lochidev/ttsky25_two_stage_opamp/docs/Report On Design Task.pdf

# Report on Design Task: A Low-power Single-ended Operational Amplifier using Sky130 PDK

1

st Lochana Katugaha
Undergraduate, Department of Electrical and Electronic Engineering Sri Lanka Institute of Information Technology Malabe, Sri Lanka
lochanakatugaha.a30@gmail.com

Abstract—This report documents a single-ended op-amp circuit design using the SKY130 PDK, intended to function as a non-inverting unity-gain buffer for low-frequency analog signals (1–10 kHz) that will be submitted to the Analog IC Student Design Contest organized by IEEE CASS CEDA Joint SL Chapter and SkillSurf.

I. INTRODUCTION

The aim of this report is to document the submitted design so that anyone can understand the design decisions that were made to build a two-stage op-amp with miller compensation using the open source, Sky130A PDK. Fig. 1 shows the circuit that was designed to meet the required specifications.

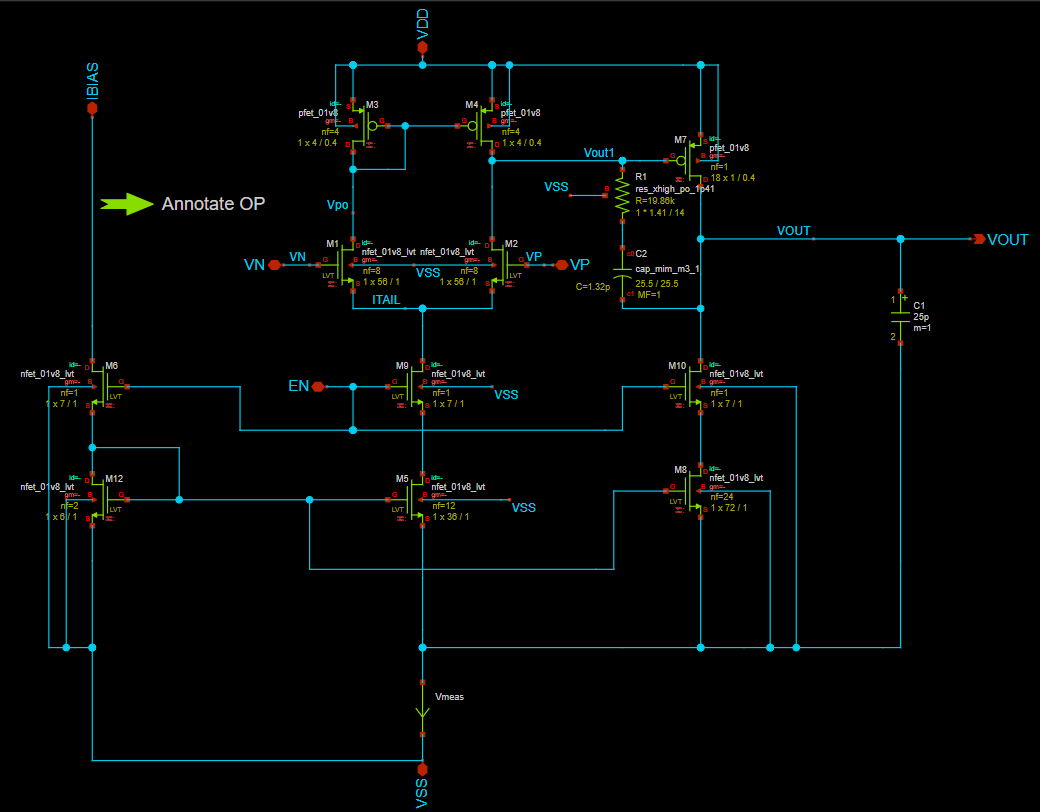
[picture p3: figure]

Fig. 1. The circuit that was designed.

II. DESIGN INPUTS AND TARGET SPECIFICATIONS

The amplifier must operate within strict power and performance constraints, targeting low-voltage and low-area applications. A non-inverting unity-gain buffer should present a high input impedance to avoid loading the preceding stage, while maintaining a low output impedance. According to [1], a higher open-loop gain results in a lower output impedance when the op-amp is used as a unity-gain buffer.

TABLE I
DESIRED PROJECT PERFORMANCE SPECIFICATIONS
Parameter | Project Specification
Technology Supply voltage VDD Nominal input common-mode voltage Output load CL Temperature range Input signal amplitude Input signal frequency Open-loop low-frequency (DC) gain ADC Gain bandwidth product (GBW) Phase Margin (PM) Quiescent current Input offset Slew rate (both open-loop and closed-loop) SR Disable current Final layout area | 130 nm CMOS 1.7 V – 1.9 V (VDD/2 − 0.2 V) – (VDD/2 + 0.2 V) 25 pF (capacitive) 20◦C to 50◦C < 0.4 Vpp 1 – 10 kHz ≥ 60 dB ≥ 1 MHz > 60◦ < 100 µA < 3 mV > 1 V/µs < 2 nA within 140 µm × 80 µm

III. POST-LAYOUT SIMULATION RESULTS
In this section, screenshots of the post layout results after parasitic extraction through magic have been included followed by Table III with a summary. All results have been obtained keeping VDD constant at 1.8 V and nominal input common-mode voltage at 0.9 V (VCM) while also using the lib file:
.lib /foss/pdks/sky130A/libs.tech/ngspice/sky130.lib.spice tt.

It was found that the circuit performs poorly (only in terms of open-loop DC gain) in the sf corner with increasing common mode voltages and Table II records the performance. Figures Fig. 2 and Fig. 3 show the open-loop low-frequency (DC) gain post-layout simulation results for the tt corner at temperatures 20◦C and 50◦C respectively.
Fig. 4 shows the normal operating point simulation result and Fig. 5 shows the operating point simulation result with enable set to logic LOW.
Fig. 6 shows the voltage transfer curve for the op-amp. Fig. 7 and Fig. 8 show open-loop transient simulation results at 1 kHz and 10 kHz respectively for a 0.1 mV sinusoidal input signal. Fig. 9 shows closed-loop transient simulation results at 1 Mhz for a sinusoidal signal of 0.4 Vpp magnitude with VCM = 0.9 V .
Fig. 10 shows transient behavior of the design in a open-loop slew rate test when a -0.4V pulse signal is applied. Fig. 11 shows a graph that shows the corresponding instantaneous slew rate.

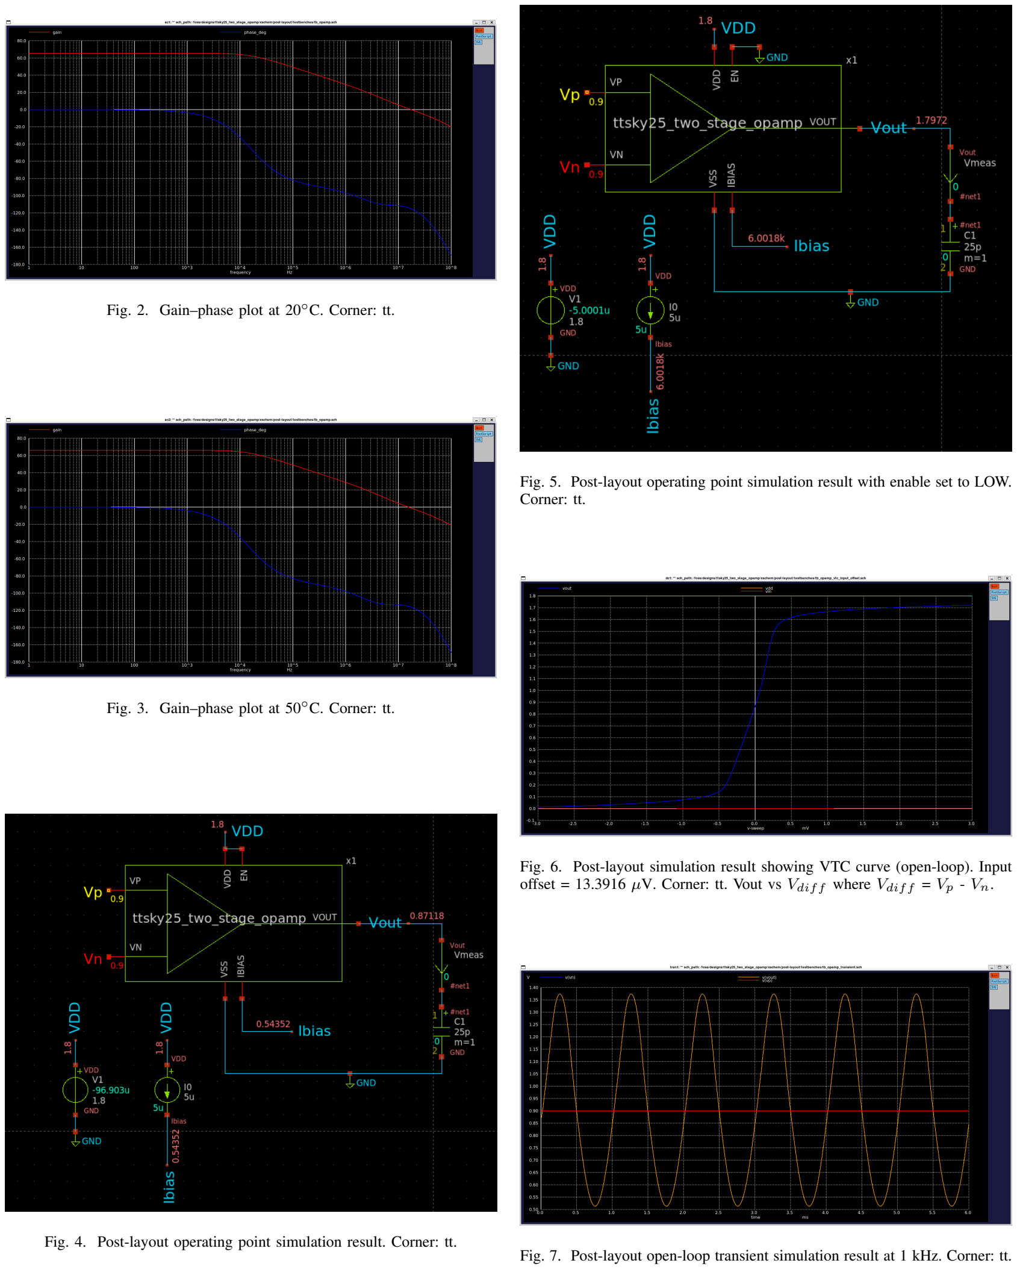
[picture p4: page 2]

Fig. 2. Gain–phase plot at 20◦C. Corner: tt.

Fig. 3. Gain–phase plot at 50◦C. Corner: tt.

Fig. 4. Post-layout operating point simulation result. Corner: tt.

Fig. 5. Post-layout operating point simulation result with enable set to LOW. Corner: tt.

Fig. 6. Post-layout simulation result showing VTC curve (open-loop). Input offset = 13.3916 µV. Corner: tt. Vout vs Vdiff where Vdiff = Vp - Vn.

Fig. 7. Post-layout open-loop transient simulation result at 1 kHz. Corner: tt.

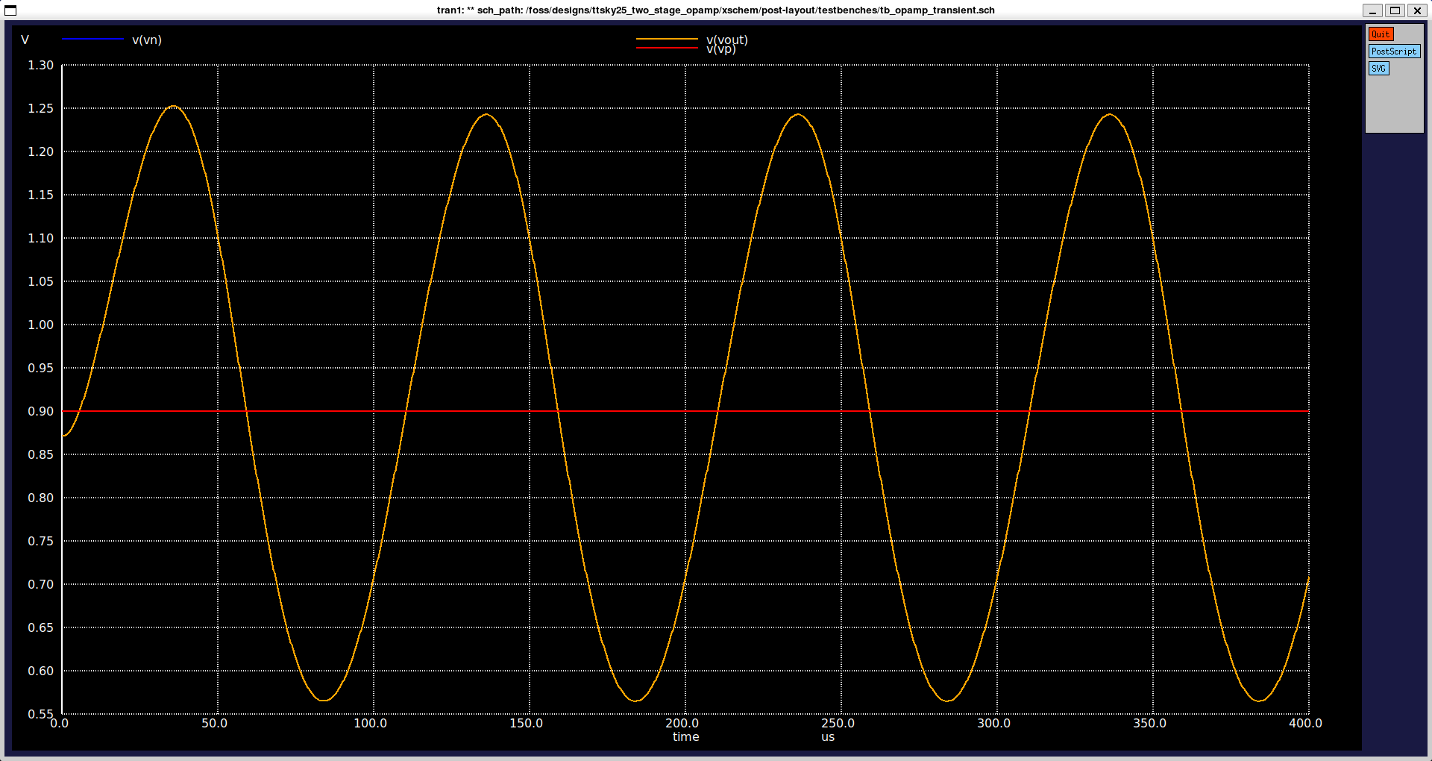
[picture p5: figure]

Fig. 8. Post-layout open-loop transient simulation result at 10 kHz. Corner: tt.

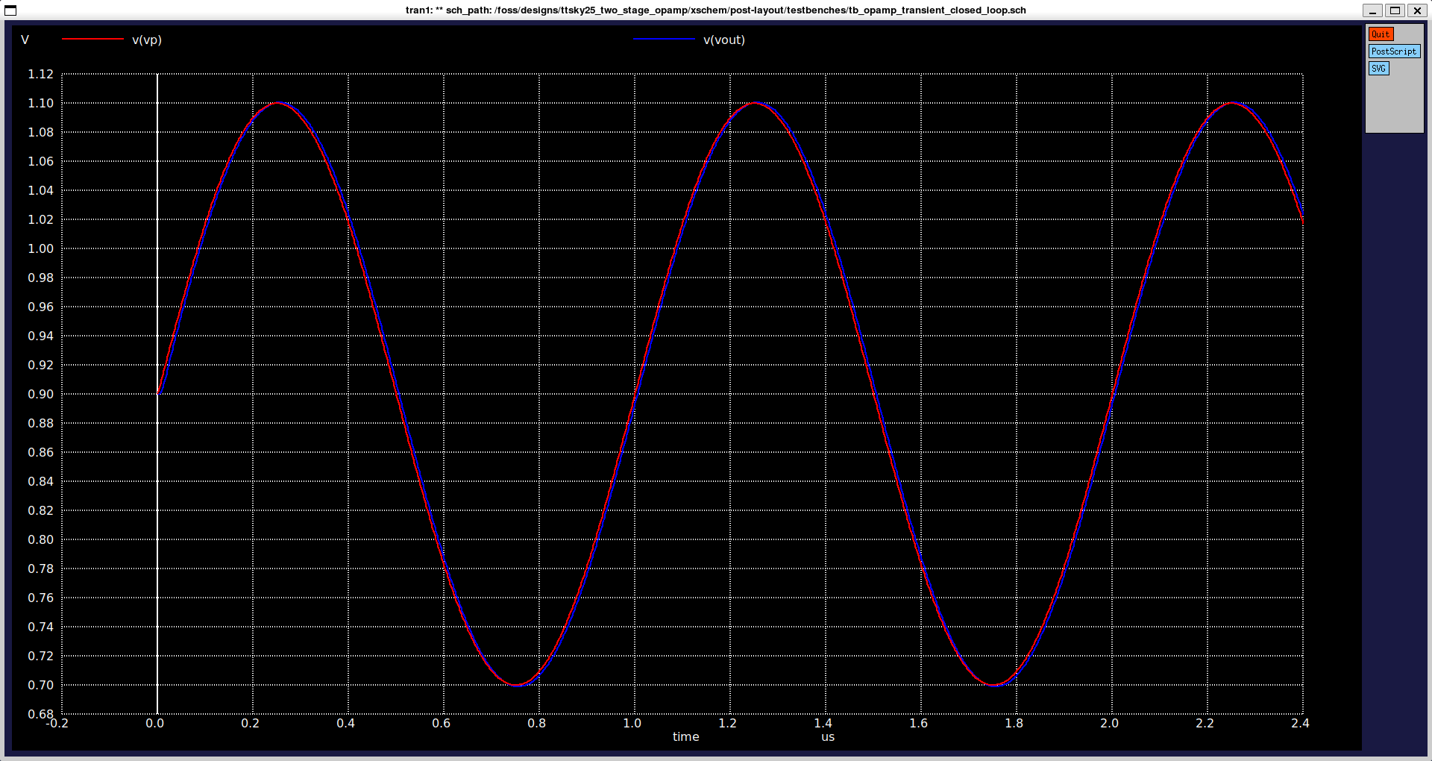
[picture p6: figure]

Fig. 9. Post-layout closed-loop transient simulation result at 1 MHz. Corner: tt.

Fig. 12 shows transient behavior of the design in a closed-loop slew rate test when a -0.4V pulse signal is applied. Fig. 13 shows a graph that shows the corresponding instantaneous slew rate.

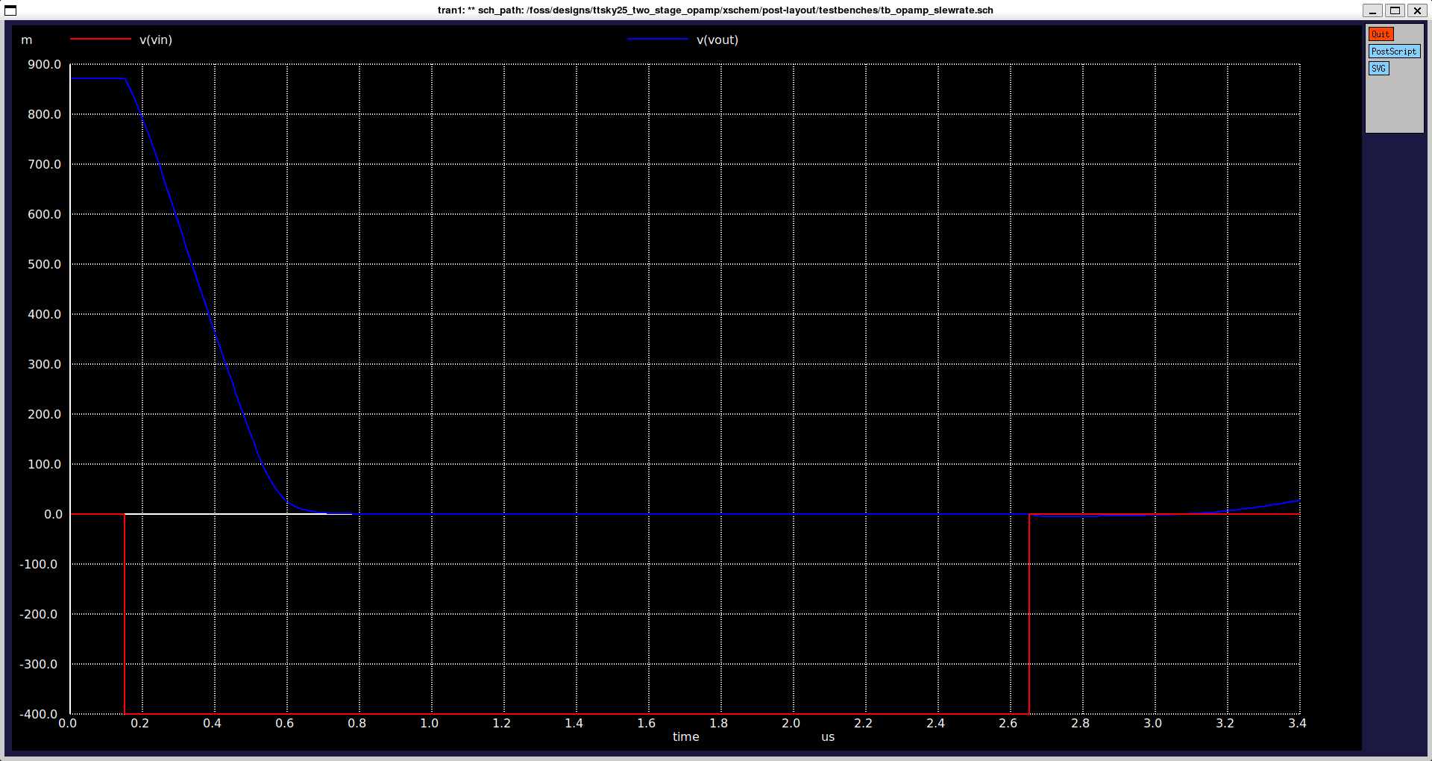
[picture p7: figure]

Fig. 10. Post-layout simulation result for open-loop slew rate transient behavior. Corner: tt.

Fig. 14 shows a cropped version of the plot of gain (dB) vs temperature (◦C) found at [4].
The testbenches used to obtain these results are modified versions of the testbenches found at [2].

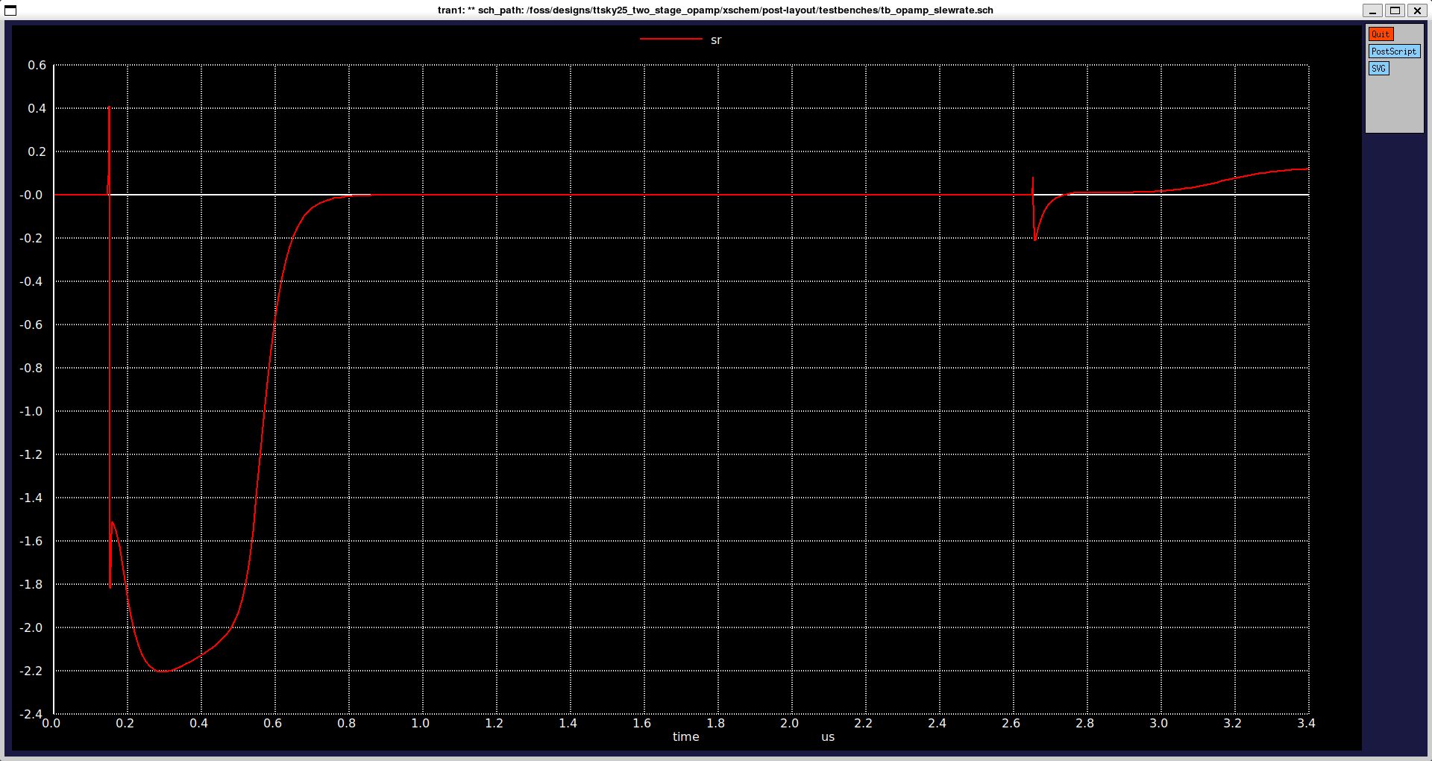
[picture p8: figure]

Fig. 11. Post-layout simulation result showing instantaneous slew rate (derivative) for plot in Fig. 10. Corner: tt.

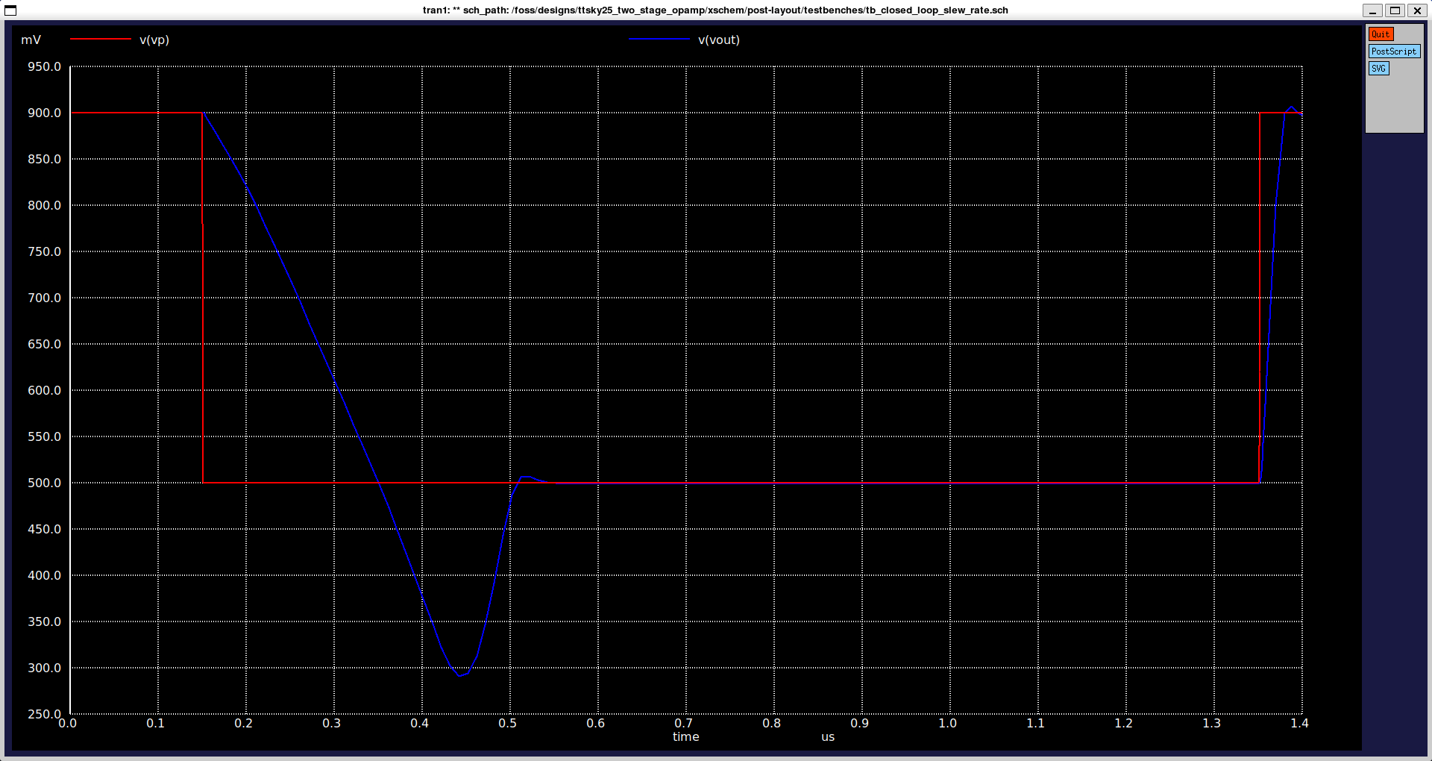
[picture p9: figure]

Fig. 12. Post-layout simulation result for closed-loop slew rate transient behavior. Corner: tt.

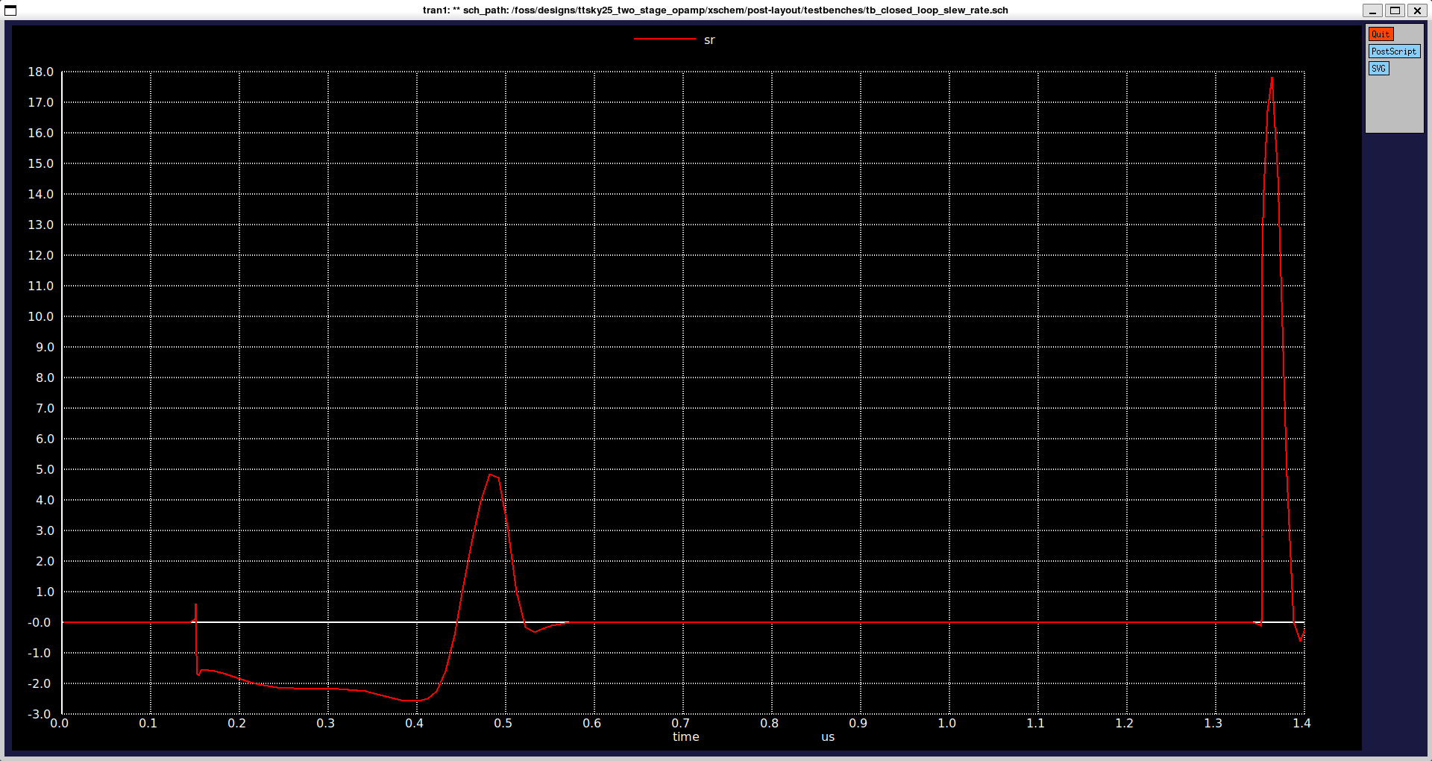
[picture p10: figure]

Fig. 13. Post-layout simulation result showing instantaneous slew rate (derivative) for plot in Fig. 12. Corner: tt.

TABLE II
EFFECT OF VCM ON OPEN-LOOP DC GAIN IN THE SF CORNER
VDD | VCM | Required ICMR | Temperature | Open-loop DC gain
1.8 V | 1.1 V | 0.7 V - 1.1 V | 20◦C | 43.050 dB
1.8 V | 1.01 V | 0.7 V - 1.1 V | 20◦C | 60.125 dB
1.7 V | 1.01 V | 0.65 V - 1.05 V | 20◦C | 37.141 dB
1.7 V | 0.89 V | 0.65 V - 1.05 V | 20◦C | 60.628 dB
1.9 V | 1.01 V | 0.75 V - 1.15 V | 20◦C | 64.127 dB

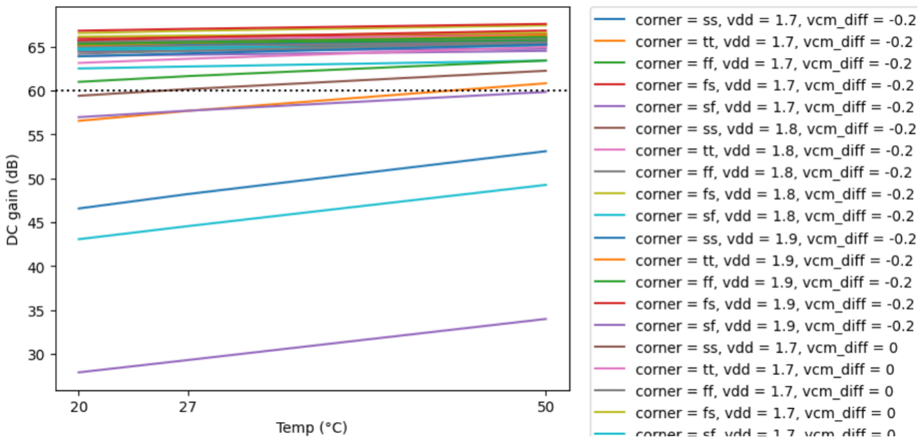
[picture p11: figure]

Fig. 14. A plot of gain (dB) vs temperature (◦C) for varying VDD, common-mode input voltage and process corners obtained through post-layout simulations using CACE. (Source: See [4])

| TABLE III
SUMMARY OF SPECIFICATIONS ACHIEVED ACROSS PVT VARIATIONS
| (VDD = 1.8 AND VCM = 0.9)
Required Specification | Post-layout results
Process corner | Temp | Value
Input Common-Mode Voltage Range | tt | 27◦C | Min: 0.6 V Max: 1.1 V
Input Common-Mode Voltage Range (Worst case) | sf | 20◦C | Min: 0.6 V Max: 1.01 V
Open-loop low-frequency (DC) gain (Max value observed) | tt ff ss sf fs tt ff ss sf fs | 20◦C 20◦C 20◦C 20◦C 20◦C 50◦C 50◦C 50◦C 50◦C 50◦C | 65.522 dB 65.346 dB 65.195 dB 63.934 dB 66.004 dB 66.059 dB 65.772 dB 65.755 dB 64.512 dB 66.494 dB
Gain bandwidth product (Assuming GBW = UGF) | tt ff ss sf fs tt ff ss sf fs | 20◦C 20◦C 20◦C 20◦C 20◦C 50◦C 50◦C 50◦C 50◦C 50◦C | 17.67 MHz 19.18 MHz 15.93 MHz 16.52 MHz 18.20 MHz 15.72 MHz 17.00 MHz 14.22 MHz 14.76 MHz 16.14 MHz
Phase margin | tt | 20◦C | 64.684◦
| ff | 20◦C | 65.191◦
| ss | 20◦C | 63.994◦
| sf | 20◦C | 64.573◦
| fs | 20◦C | 64.605◦
| tt | 50◦C | 64.754◦
| ff | 50◦C | 65.580◦
| ss | 50◦C | 63.663◦
| sf | 50◦C | 64.323◦
| fs | 50◦C | 64.896◦
Quiescent current | tt | 27◦C | 96.903 µA
Input offset | tt | 27◦C | 13.3916 µV
Slew rate (open-loop, negative pulse) | tt | 27◦C | -2.20 V/µs
Slew rate (open-loop, positive pulse) | tt | 27◦C | 15.88 V/µs
Slew rate (closed-loop, negative pulse) | tt | 27◦C | -2.56 V/µs
Slew rate (closed-loop, positive pulse) | tt | 27◦C | 8.10 V/µs
Disable current | tt | 27◦C | 100 pA
Output node current | tt | 27◦C | -
Layout area | - | - | 48.5 ∗ 57.26 µm²

IV. MONTE CARLO SIMULATION RESULTS
Fig. 15 shows a histogram made using data obtained through 4500 tests run by CACE. The default documentation generated by CACE (including Monte Carlo results) can be found at [4]. The MC switch found in the combined sky130.lib.spice file was used for this, and the full data set can be found at [6]. These Monte Carlo results were obtained using, 150 MC switch process variations each for 3 temperature variations (20◦C, 27◦C, 50◦C) * 3 VDD variations (1.7 V, 1.8 V, 1.9 V) * 3 VCM variations. The VCM variations were calculated depending on the VDD value, as shown in (1) where VCM diff was constrained to three discrete values (0, +0.2 V, and −0.2 V).
V DD
2

− VCM diff
≤ VCM ≤
V DD
2

+ VCM diff
(1)

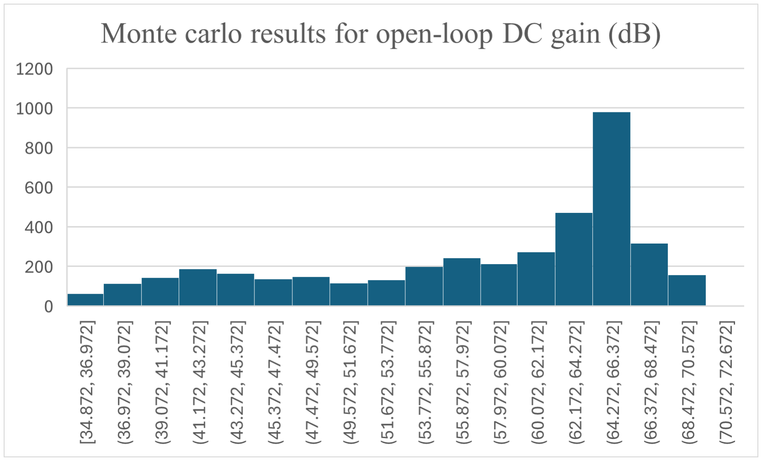
[picture p12: figure]

Fig. 15. Monte Carlo simulation attempt with 4050 runs

TABLE IV
AN ATTEMPT AT 3-SIGMA ANALYSIS OF DC GAIN USING 4500 MONTE CARLO RUNS
Mean open-loop DC gain | 57.72378807 dB
Standard Deviation | 9.412357149 dB
Median | 61.70855 dB
1σ - Count and percentage | 2850 (70.370%)
2σ - Count and percentage | 3883 (95.877%)
3σ - Count and percentage | 4050 (100%)
V. SIZING TRANSISTORS
A. Sky130A PDK Specific Considerations
Different results were obtained depending on the different sky130.lib.spice file that was used. They are found in the lib.tech folder:
.lib/foss/pdks/sky130A/libs.tech/ngspice/sky130.lib.spice, .lib/foss/pdks/sky130A/libs.tech/combined/sky130.lib.spice.

In order to match the results obtained by these different files it was decided that the design would use only ”binned” W
L
ratios found in files such as:

”/foss/pdks/sky130A/libs.ref/sky130 fd pr/spice/sky130 fd pr nfet 01v8 lvt tt discrete.corner.spice” and ”/foss/pdks/sky130A/libs.ref/sky130 fd pr/spice/sky130 fd pr pfet 01v8 tt discrete.corner.spice”.

Due to various community discussions such as [3] and
[5] about the the pfet 01v8 model, it was decided that the maximum channel length of PFETs used in the design would be 0.4 µm.

VI. LAYOUT
A. Completed layout and layout plan
It was ensured that the layout was compact, had 0 DRC errors and was passing LVS. Area used by the layout is 2777.110 µm² with a width of 48.500 µm and a length of 57.260 µm. Fig. 16 shows the completed layout. Fig. 17 shows the layout plan.

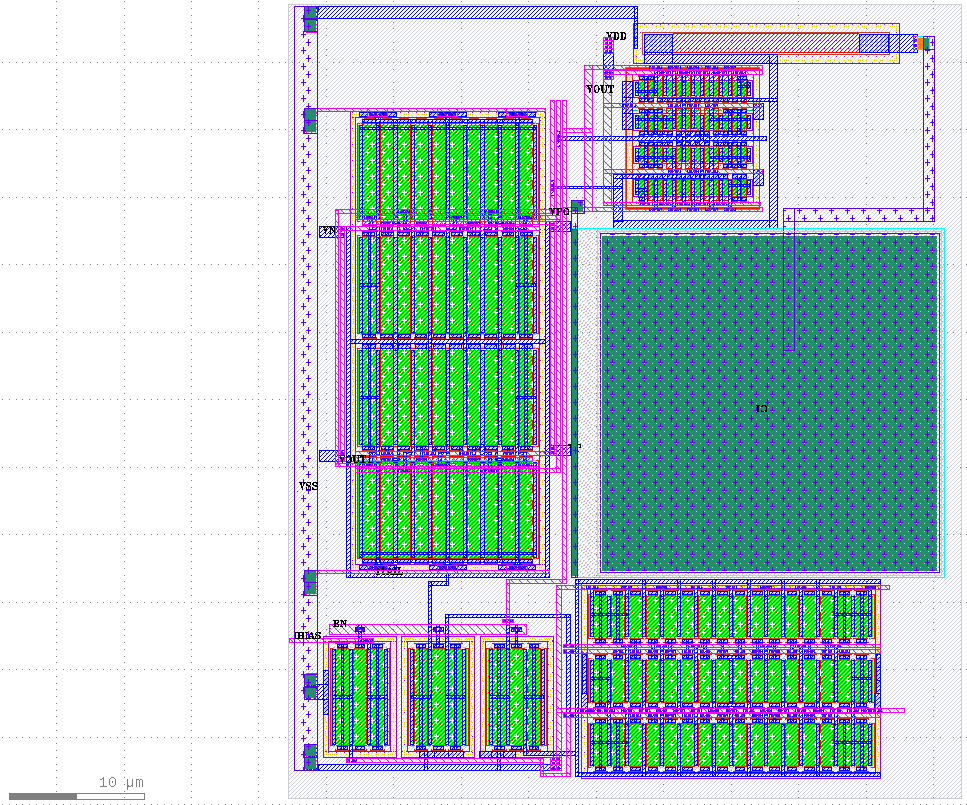
[picture p13: figure]

Fig. 16. Final layout of the two stage operational amplifier.

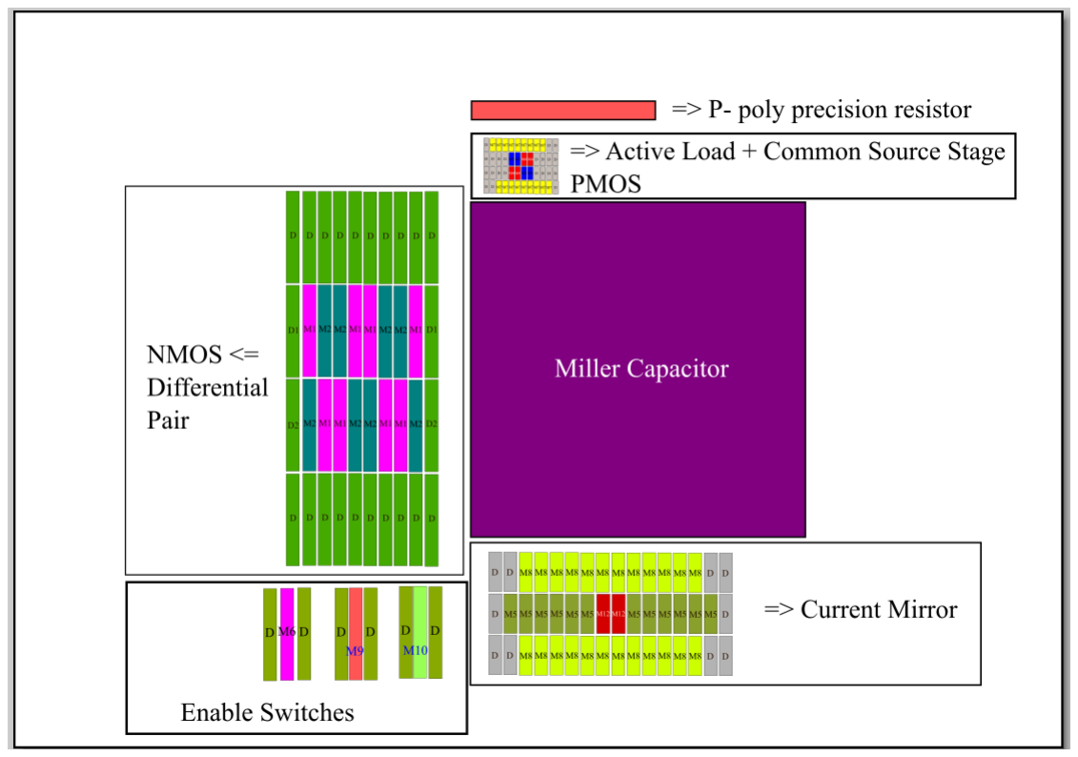
[picture p14: figure]

Fig. 17. Layout plan for the two stage operational amplifier.

B. Explanation of the layout of the NMOS differential pair

This was the most crucial part of the layout as the two MOSFETs M1 and M2 needed to be matched with very high accuracy. A common centroid layout made of 8 fingers each from M1 and M2 was used with each finger having a

W
L

=

7/1. These are the largest fingers in terms of size in the entire layout, which may make it more susceptible to process gradients. Therefore, these fingers were placed as close as possible. Attempts were made to ensure that routing was symmetrical as well. The differential pair was surrounded by dummy transistors. There may be unforeseen complications arising due to the D1 and D2 dummy transistors being connected to the drains of M1 and M2, respectively. This was only noted after completing much of the layout and when changes were made to it so that all the terminals were connected to the source node (ITAIL) of M1 and M2, the post-layout results were worse, so the decision was made to keep it as it is. Fig. 18 shows the layout plan of the NMOS differential pair.

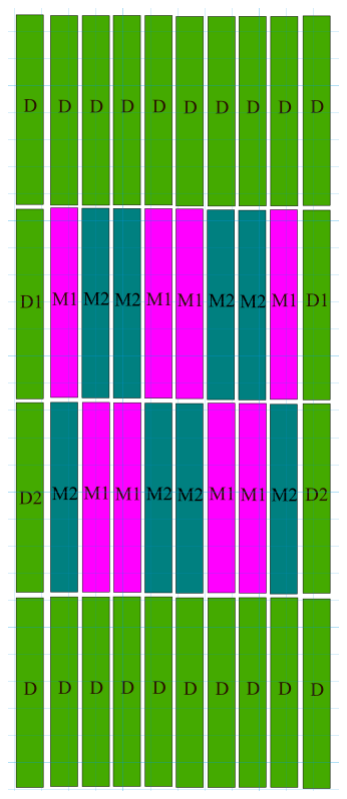
[picture p15: figure]

Fig. 18. Layout plan for the NMOS differential pair.

C. Explanation of the layout of the PMOS active loads and the common source stage input MOSFET

This was the second most crucial part of the layout as the two MOSFETs that form the active loads of the first stage, M3 and M4 needed to be matched. The common source stage MOSFET M7 also needed to be matched. A common centroid layout made of 4 fingers each from M3 and M4 was used with each finger having a W
L

=

1
0.4

. M3 and M4 are surrounded by dummy transistors from all sides, while M7 was only surrounded by the left and right to save time during layout so that post-layout simulations could be performed as soon as possible. Fig. 19 shows the layout plan of these PFETs.

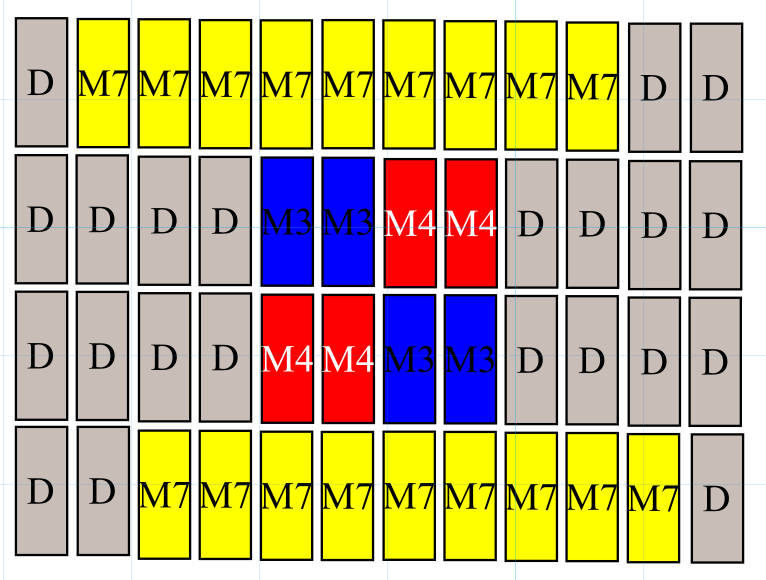
[picture p16: figure]

Fig. 19. Layout plan for all the PFETs in the layout.

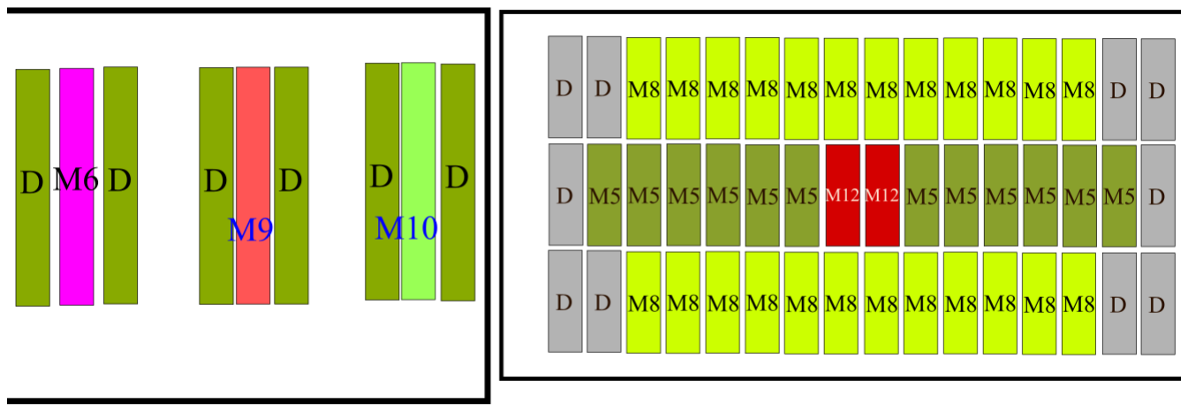
[picture p17: figure]

Fig. 20. Layout plan for current mirror and enable switches.

D. Explanation of the layout of the NMOS current mirror and enable switches
This was also a crucial part of the layout as the three MOSFETs M12, M5 and M8 needed to be matched. The enable switches were not matched to save time and were laid out seperately from the current mirror. An attempt at a common centroid layout made of 38 fingers with each finger having a W
L

=

3
1 was made. The goal here was to keep M5 and M8 as close as possible to M12 since M12 was considered as the reference device. M5 is surrounded by identical fingers (including dummy transistors) on all sides however M8 is only surrounded by the left and right sides. Fig. 20 shows the layout plan for the current mirror and enable switches. The enable switches also had dummy transistors on the left and right but they may not be required.

VII. CONCLUSION
Since the post-layout results obtained in the sf corner showed poor performance, the design may not be able to operate with common mode voltage inputs above 1.01 V. Power supply variations may affect performance even further. In conclusion, it can be said that the design, even for most PVT variations, can act reliably as a non-inverting unity-gain buffer for low-frequency analog signals with a magnitude of about 0.4 Vpp if used with a DC offset of about 0.8 V while keeping VDD constant at 1.8 V. Fig. 21 shows post-layout results under such conditions.

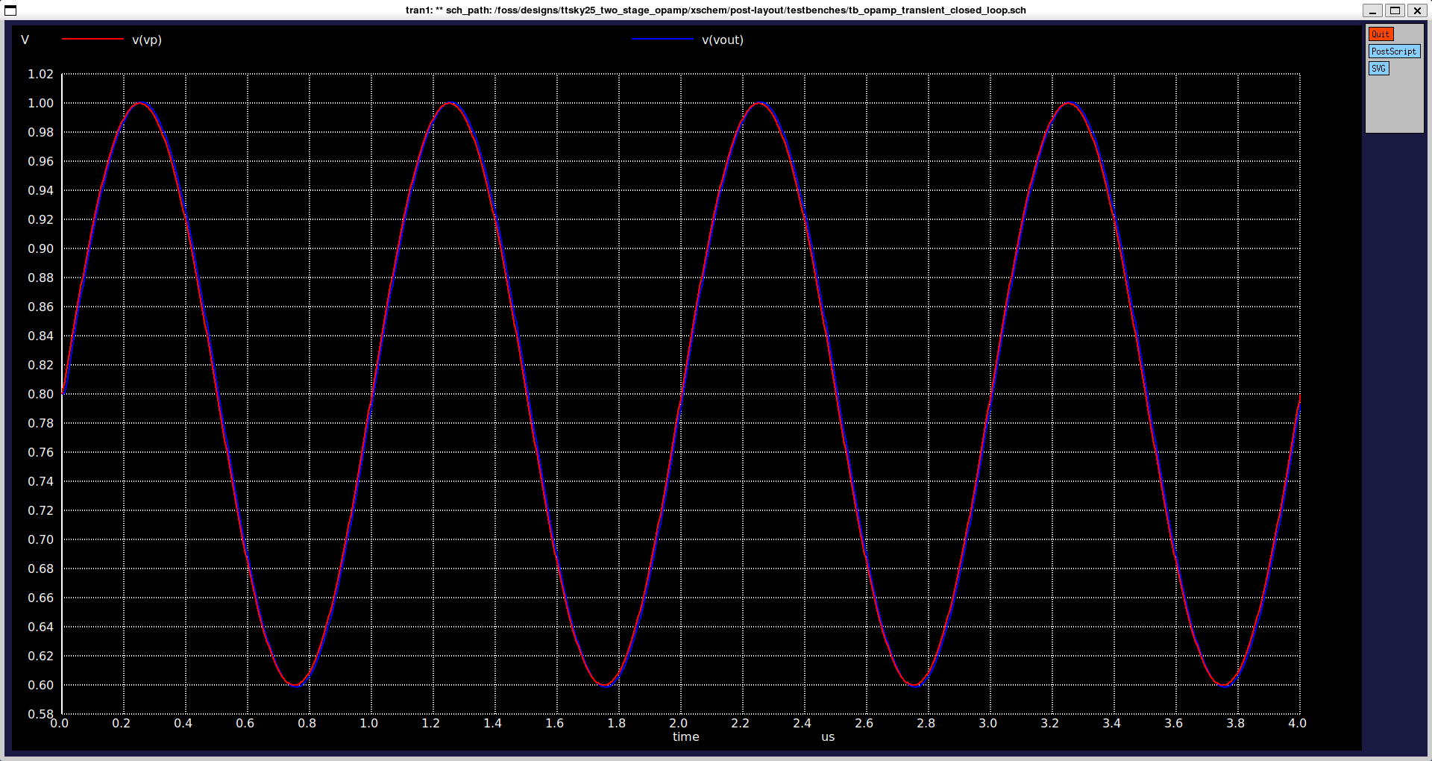
[picture p18: figure]

Fig. 21. Post-layout closed-loop transient simulation result at 1 MHz for 0.4 Vpp signal. Corner: sf.

REFERENCES

[1] B. Razavi, Design of Analog CMOS Integrated Circuits, 2nd ed. New York, NY, USA: McGraw-Hill, 2016, p. 288.
[2] https://github.com/SkillSurf/ttsky25 se opamp/tree/main/xschem (https://github.com/SkillSurf/ttsky25_se_opamp/tree/main/xschem)
[3] https://github.com/bmurmann/Book-on-gm-ID-design/blob/main/ starter files open source tools/sky130/README.md (https://github.com/bmurmann/Book-on-gm-ID-design/blob/main/starter_files_open_source_tools/sky130/README.md)
[4] https://github.com/lochidev/ttsky25 two stage opamp/blob/main/docs/ ttsky25 two stage opamp rcx.md (https://github.com/lochidev/ttsky25_two_stage_opamp/blob/main/docs/ttsky25_two_stage_opamp_rcx.md)
[5] https://web.open-source-silicon.dev/t/16600198/are-there-near-plansto-fix-the-skywater-analog-models-the-m (https://web.open-source-silicon.dev/t/16600198/are-there-near-plans-to-fix-the-skywater-analog-models-the-m)
[6] https://github.com/lochidev/ttsky25 two stage opamp/blob/main/docs/ results/monte-carlo/mc 4050.xlsx (https://github.com/lochidev/ttsky25_two_stage_opamp/blob/main/docs/results/monte-carlo/mc_4050.xlsx)
