lochidev/ttsky25_two_stage_opamp/docs/ttsky25_two_stage_opamp/rcx/gain_mm.png

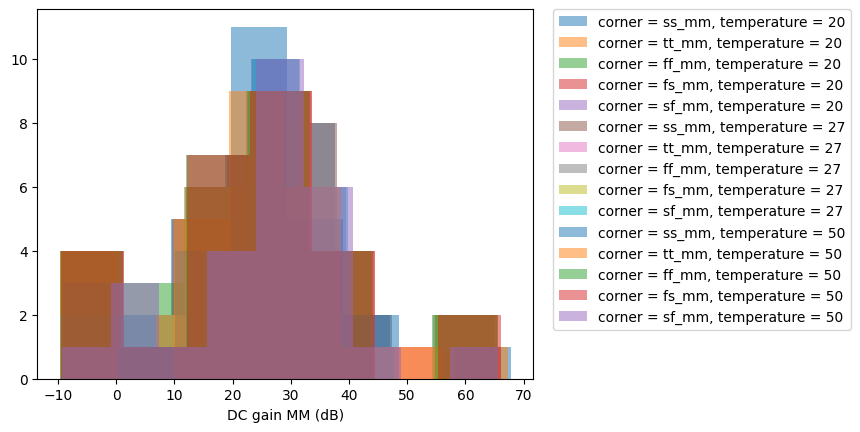
docs/ttsky25_two_stage_opamp/rcx/gain_mm.png
