lochidev/ttsky25_two_stage_opamp/xschem/post-layout/testbenches/README.md

Please use the xschemrc file to launch xschem so that the symbol will be loaded correctly. 
Example:
```xschem tb_Opamp.sch```

Please adjust the include statement to use the spice file at:

https://github.com/lochidev/ttsky25_two_stage_opamp/blob/main/netlist/rcx/ttsky25_two_stage_opamp.spice

These are modified testbenches from: https://github.com/SkillSurf/ttsky25_se_opamp/tree/main/xschem
