lochidev/ttsky25_two_stage_opamp/xschem/post-layout/lvs/results/README.md

Run the command:
```
netgen -batch lvs "two_stage_opamp.spice two_stage_opamp"   "two_stage_op_amp_xschem.spice two_stage_op_amp_xschem"    $PDK_ROOT/sky130A/libs.tech/netgen/sky130A_setup.tcl  lvs.log
```
