lochidev/ttsky25_two_stage_opamp/docs/results/dc_params_lib_combined/simulation_summary.md

# Simulation Summary for DC Params libs.tech/combined

| run | corner | temperature | vdd | vcm_diff | gain_max | ugf | pm |
| :-- | -----: | ---: | --: | ---: | ---: | --: | -: |
| run_000 | ss | 20 | 1.7 | -0.2 | 65.089 | 1.533e+07 | 64.421 |
| run_001 | tt | 20 | 1.7 | -0.2 | 65.105 | 1.627e+07 | 64.923 |
| run_002 | ff | 20 | 1.7 | -0.2 | 65.009 | 1.714e+07 | 65.415 |
| run_003 | fs | 20 | 1.7 | -0.2 | 65.107 | 1.565e+07 | 64.641 |
| run_004 | sf | 20 | 1.7 | -0.2 | 64.829 | 1.667e+07 | 65.294 |
| run_005 | ss | 27 | 1.7 | -0.2 | 65.186 | 1.508e+07 | 64.429 |
| run_006 | tt | 27 | 1.7 | -0.2 | 65.187 | 1.599e+07 | 64.956 |
| run_007 | ff | 27 | 1.7 | -0.2 | 65.082 | 1.683e+07 | 65.470 |
| run_008 | fs | 27 | 1.7 | -0.2 | 65.200 | 1.540e+07 | 64.663 |
| run_009 | sf | 27 | 1.7 | -0.2 | 64.912 | 1.637e+07 | 65.331 |
| run_010 | ss | 50 | 1.7 | -0.2 | 65.458 | 1.428e+07 | 64.415 |
| run_011 | tt | 50 | 1.7 | -0.2 | 65.420 | 1.508e+07 | 65.017 |
| run_012 | ff | 50 | 1.7 | -0.2 | 65.288 | 1.583e+07 | 65.598 |
| run_013 | fs | 50 | 1.7 | -0.2 | 65.455 | 1.459e+07 | 64.695 |
| run_014 | sf | 50 | 1.7 | -0.2 | 65.148 | 1.540e+07 | 65.400 |
| run_015 | ss | 20 | 1.8 | -0.2 | 65.629 | 1.607e+07 | 64.496 |
| run_016 | tt | 20 | 1.8 | -0.2 | 65.499 | 1.687e+07 | 64.980 |
| run_017 | ff | 20 | 1.8 | -0.2 | 65.331 | 1.767e+07 | 65.455 |
| run_018 | fs | 20 | 1.8 | -0.2 | 65.647 | 1.649e+07 | 64.661 |
| run_019 | sf | 20 | 1.8 | -0.2 | 65.233 | 1.718e+07 | 65.373 |
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
| run_131 | tt | 50 | 1.9 | 0.2 | 66.239 | 1.699e+07 | 64.693 |
| run_132 | ff | 50 | 1.9 | 0.2 | 65.871 | 1.776e+07 | 65.174 |
| run_133 | fs | 50 | 1.9 | 0.2 | 68.200 | 1.702e+07 | 64.463 |
| run_134 | sf | 50 | 1.9 | 0.2 | 60.987 | 1.565e+07 | 64.434 |
