lochidev/ttsky25_two_stage_opamp/docs/results/dc_params_lib_ngspice/simulation_summary.md

# Simulation Summary for DC Params libs.tech/ngspice

| run | corner | temperature | vdd | vcm_diff | gain_max | ugf | pm |
| :-- | -----: | ---: | --: | ---: | ---: | --: | -: |
| run_000 | ss | 20 | 1.7 | -0.2 | 64.770 | 1.444e+07 | 63.969 |
| run_001 | tt | 20 | 1.7 | -0.2 | 65.145 | 1.616e+07 | 64.848 |
| run_002 | ff | 20 | 1.7 | -0.2 | 65.051 | 1.763e+07 | 65.480 |
| run_003 | fs | 20 | 1.7 | -0.2 | 65.094 | 1.629e+07 | 64.980 |
| run_004 | sf | 20 | 1.7 | -0.2 | 64.443 | 1.542e+07 | 64.647 |
| run_005 | ss | 27 | 1.7 | -0.2 | 64.862 | 1.409e+07 | 63.868 |
| run_006 | tt | 27 | 1.7 | -0.2 | 65.226 | 1.575e+07 | 64.849 |
| run_007 | ff | 27 | 1.7 | -0.2 | 65.116 | 1.716e+07 | 65.560 |
| run_008 | fs | 27 | 1.7 | -0.2 | 65.165 | 1.588e+07 | 65.016 |
| run_009 | sf | 27 | 1.7 | -0.2 | 64.526 | 1.502e+07 | 64.572 |
| run_010 | ss | 50 | 1.7 | -0.2 | 65.117 | 1.304e+07 | 63.350 |
| run_011 | tt | 50 | 1.7 | -0.2 | 65.456 | 1.449e+07 | 64.629 |
| run_012 | ff | 50 | 1.7 | -0.2 | 65.294 | 1.574e+07 | 65.579 |
| run_013 | fs | 50 | 1.7 | -0.2 | 65.347 | 1.463e+07 | 64.906 |
| run_014 | sf | 50 | 1.7 | -0.2 | 64.771 | 1.384e+07 | 64.124 |
| run_015 | ss | 20 | 1.8 | -0.2 | 65.322 | 1.511e+07 | 64.123 |
| run_016 | tt | 20 | 1.8 | -0.2 | 65.534 | 1.675e+07 | 64.921 |
| run_017 | ff | 20 | 1.8 | -0.2 | 65.354 | 1.818e+07 | 65.509 |
| run_018 | fs | 20 | 1.8 | -0.2 | 65.582 | 1.712e+07 | 64.963 |
| run_019 | sf | 20 | 1.8 | -0.2 | 64.853 | 1.589e+07 | 64.792 |
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
| run_131 | tt | 50 | 1.9 | 0.2 | 66.272 | 1.634e+07 | 64.591 |
| run_132 | ff | 50 | 1.9 | 0.2 | 66.115 | 1.783e+07 | 65.415 |
| run_133 | fs | 50 | 1.9 | 0.2 | 67.583 | 1.697e+07 | 64.816 |
| run_134 | sf | 50 | 1.9 | 0.2 | 59.830 | 1.392e+07 | 63.676 |
