lochidev/ttsky25_two_stage_opamp/docs/results/monte-carlo/mc_3600_no_vcm.xlsx

iteration | gain_max | ugf | pm | temperature | vdd | Results were obtained for:
1 | 43.0275 | 14807500 | 68.9718 | 20 | 1.7 | 400 mc switch, process variations * 3 temp variations * 3 VDD variations
2 | 51.2503 | 15713000 | 66.4931 | 20 | 1.7 | Monte Carlo Analysis of all 3600 runs for DC gain
3 | 60.2502 | 16354800 | 65.02 | 20 | 1.7 | Mean Gain (dB): | 58.06792481
4 | 63.8729 | 17097100 | 64.5529 | 20 | 1.7 | Standard Deviation (dB): | 10.01981694
5 | 35.9053 | 11404600 | 68.9731 | 20 | 1.7 | Median (dB) | 63.6634
6 | 64.9514 | 17347900 | 64.4111 | 20 | 1.7 | 1σ - Count | 2483
7 | 63.6128 | 16893600 | 64.5907 | 20 | 1.7 | 1σ - Percentage | 68.972%
8 | 63.7944 | 17084800 | 64.5347 | 20 | 1.7 | 2σ - Count | 3479
9 | 41.7042 | 13372000 | 67.0105 | 20 | 1.7 | 2σ - Percentage | 96.639%
10 | 50.0797 | 15441800 | 65.1861 | 20 | 1.7 | 3σ - Count | 3600
11 | 48.1458 | 14931900 | 65.5365 | 20 | 1.7 | 3σ - Percentage | 100.000%
12 | 64.6323 | 17442000 | 64.3666 | 20 | 1.7
13 | 64.2952 | 17342700 | 64.4714 | 20 | 1.7
14 | 64.4338 | 17386700 | 64.4469 | 20 | 1.7
15 | 66.1368 | 17598200 | 64.2507 | 20 | 1.7
16 | 40.7752 | 13045300 | 67.2081 | 20 | 1.7
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
