lochidev/ttsky25_two_stage_opamp/docs/results/monte-carlo/mc_4050.xlsx

Sheet: mc_results_full
iteration | gain_max | ugf | pm | temperature | vdd | vcm_diff | Results obtained using,
1 | 38.2996 | 12702800 | 72.4198 | 20 | 1.7 | -0.2 | 150 mc switch process variations each for 3 temp variations * 3 VDD variations * 3 Vcm variations
2 | 41.4434 | 13609500 | 70.5661 | 20 | 1.7 | -0.2 | Monte Carlo Analysis of all 4500 runs for DC gain (150 * 3 * 3 * 3 = 4050)
3 | 45.7327 | 14316400 | 68.6864 | 20 | 1.7 | -0.2 | Mean Gain (dB): | 57.72378807
4 | 64.3569 | 15856000 | 64.9807 | 20 | 1.7 | -0.2 | Standard Deviation (dB): | 9.412357149
5 | 37.4014 | 10689000 | 69.3988 | 20 | 1.7 | -0.2 | Median (dB) | 61.70855
6 | 65.0411 | 16176200 | 64.9471 | 20 | 1.7 | -0.2 | 1σ - Count | 2850
7 | 61.9609 | 15487500 | 65.2249 | 20 | 1.7 | -0.2 | 1σ - Percentage | 70.370%
8 | 63.6218 | 15736200 | 65.0202 | 20 | 1.7 | -0.2 | 2σ - Count | 3883
9 | 44.4156 | 13068000 | 67.003 | 20 | 1.7 | -0.2 | 2σ - Percentage | 95.877%
10 | 58.4819 | 15753400 | 64.8744 | 20 | 1.7 | -0.2 | 3σ - Count | 4050
11 | 56.7329 | 15424400 | 65.056 | 20 | 1.7 | -0.2 | 3σ - Percentage | 100.000%
12 | 65.1033 | 16320900 | 64.8777 | 20 | 1.7 | -0.2 | >= 60dB - Count | 2205
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
