lochidev/ttsky25_two_stage_opamp/docs/results/monte-carlo/mc_results_full.csv

iteration | gain_max | ugf | pm | temperature | vdd | vcm_diff
1 | 38.2996 | 12702800.0 | 72.4198 | 20 | 1.7 | -0.2
2 | 41.4434 | 13609500.0 | 70.5661 | 20 | 1.7 | -0.2
3 | 45.7327 | 14316400.0 | 68.6864 | 20 | 1.7 | -0.2
4 | 64.3569 | 15856000.0 | 64.9807 | 20 | 1.7 | -0.2
5 | 37.4014 | 10689000.0 | 69.3988 | 20 | 1.7 | -0.2
6 | 65.0411 | 16176200.0 | 64.9471 | 20 | 1.7 | -0.2
7 | 61.9609 | 15487500.0 | 65.2249 | 20 | 1.7 | -0.2
8 | 63.6218 | 15736200.0 | 65.0202 | 20 | 1.7 | -0.2
9 | 44.4156 | 13068000.0 | 67.003 | 20 | 1.7 | -0.2
10 | 58.4819 | 15753400.0 | 64.8744 | 20 | 1.7 | -0.2
11 | 56.7329 | 15424400.0 | 65.056 | 20 | 1.7 | -0.2
12 | 65.1033 | 16320900.0 | 64.8777 | 20 | 1.7 | -0.2
13 | 64.9266 | 16182200.0 | 64.9455 | 20 | 1.7 | -0.2
14 | 65.0586 | 16270100.0 | 64.934 | 20 | 1.7 | -0.2
15 | 65.4213 | 16547800.0 | 64.8861 | 20 | 1.7 | -0.2
16 | 43.4733 | 12751200.0 | 67.1765 | 20 | 1.7 | -0.2
17 | 58.772 | 15433600.0 | 65.618 | 20 | 1.7 | -0.2
18 | 65.2601 | 16311500.0 | 64.9466 | 20 | 1.7 | -0.2
19 | 47.5589 | 14553500.0 | 68.0017 | 20 | 1.7 | -0.2
20 | 65.6581 | 16618200.0 | 64.8717 | 20 | 1.7 | -0.2
21 | 41.7609 | 12219200.0 | 67.6663 | 20 | 1.7 | -0.2
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
