lochidev/ttsky25_two_stage_opamp/xschem/post-layout/testbenches/vtc_input_offset.png

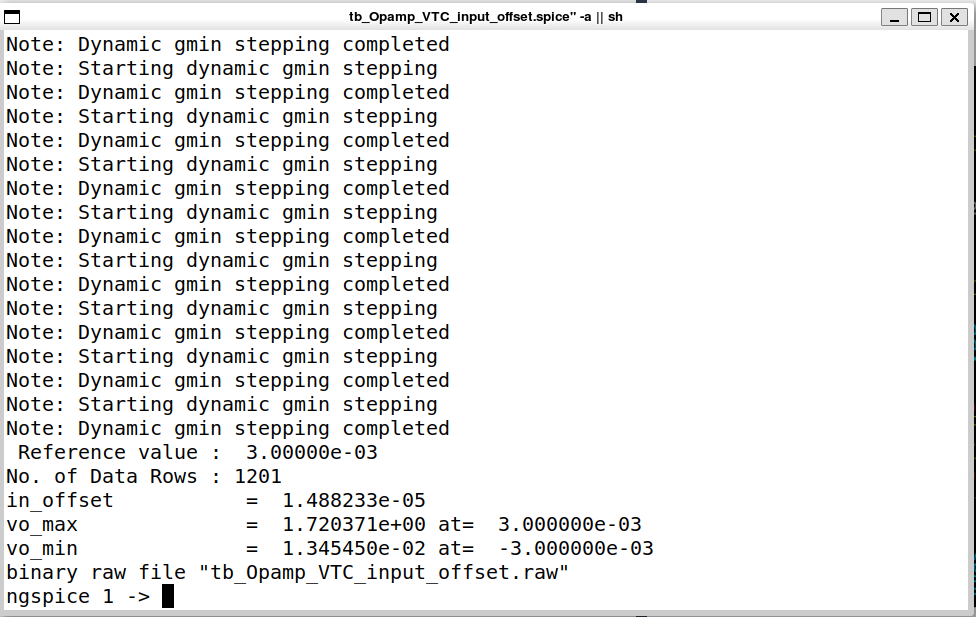
xschem/post-layout/testbenches/vtc_input_offset.png
