lochidev/ttsky25_two_stage_opamp/netlist/schematic/ttsky25_two_stage_opamp.spice

** sch_path: /foss/designs/ttsky25_two_stage_opamp/xschem/ttsky25_two_stage_opamp.sch
.subckt ttsky25_two_stage_opamp VDD IBIAS VOUT VN VP EN VSS
*.PININFO VSS:B VDD:B IBIAS:B VOUT:O EN:B VN:B VP:B
XC2 net1 VOUT sky130_fd_pr__cap_mim_m3_1 W=25.5 L=25.5 MF=1 m=1
XM5 net2 net2 net2 VSS sky130_fd_pr__nfet_01v8_lvt L=1 W=7 nf=1 ad=2.03 as=2.03 pd=14.58 ps=14.58 nrd=0.0414285714285714
+ nrs=0.0414285714285714 sa=0 sb=0 sd=0 mult=1 m=1
XM6 IBIAS EN net2 VSS sky130_fd_pr__nfet_01v8_lvt L=1 W=7 nf=1 ad=2.03 as=2.03 pd=14.58 ps=14.58 nrd=0.0414285714285714
+ nrs=0.0414285714285714 sa=0 sb=0 sd=0 mult=1 m=1
XM8 IBIAS IBIAS IBIAS VSS sky130_fd_pr__nfet_01v8_lvt L=1 W=7 nf=1 ad=2.03 as=2.03 pd=14.58 ps=14.58 nrd=0.0414285714285714
+ nrs=0.0414285714285714 sa=0 sb=0 sd=0 mult=1 m=1
XM9 Vz Vz Vz VSS sky130_fd_pr__nfet_01v8_lvt L=1 W=7 nf=1 ad=2.03 as=2.03 pd=14.58 ps=14.58 nrd=0.0414285714285714
+ nrs=0.0414285714285714 sa=0 sb=0 sd=0 mult=1 m=1
XM10 Vz EN net3 VSS sky130_fd_pr__nfet_01v8_lvt L=1 W=7 nf=1 ad=2.03 as=2.03 pd=14.58 ps=14.58 nrd=0.0414285714285714
+ nrs=0.0414285714285714 sa=0 sb=0 sd=0 mult=1 m=1
XM11 net3 net3 net3 VSS sky130_fd_pr__nfet_01v8_lvt L=1 W=7 nf=1 ad=2.03 as=2.03 pd=14.58 ps=14.58 nrd=0.0414285714285714
+ nrs=0.0414285714285714 sa=0 sb=0 sd=0 mult=1 m=1
XM13 VOUT EN net4 VSS sky130_fd_pr__nfet_01v8_lvt L=1 W=7 nf=1 ad=2.03 as=2.03 pd=14.58 ps=14.58 nrd=0.0414285714285714
+ nrs=0.0414285714285714 sa=0 sb=0 sd=0 mult=1 m=1
XM14 VOUT VOUT VOUT VSS sky130_fd_pr__nfet_01v8_lvt L=1 W=7 nf=1 ad=2.03 as=2.03 pd=14.58 ps=14.58 nrd=0.0414285714285714
+ nrs=0.0414285714285714 sa=0 sb=0 sd=0 mult=1 m=1
XM15 net4 net4 net4 VSS sky130_fd_pr__nfet_01v8_lvt L=1 W=7 nf=1 ad=2.03 as=2.03 pd=14.58 ps=14.58 nrd=0.0414285714285714
+ nrs=0.0414285714285714 sa=0 sb=0 sd=0 mult=1 m=1
XM16 net2 net2 VSS VSS sky130_fd_pr__nfet_01v8_lvt L=1 W=3 nf=1 ad=0.87 as=0.87 pd=6.58 ps=6.58 nrd=0.0966666666666667
+ nrs=0.0966666666666667 sa=0 sb=0 sd=0 mult=1 m=1
XM17 net2 net2 VSS VSS sky130_fd_pr__nfet_01v8_lvt L=1 W=3 nf=1 ad=0.87 as=0.87 pd=6.58 ps=6.58 nrd=0.0966666666666667
+ nrs=0.0966666666666667 sa=0 sb=0 sd=0 mult=1 m=1
XM18 net3 net2 VSS VSS sky130_fd_pr__nfet_01v8_lvt L=1 W=3 nf=1 ad=0.87 as=0.87 pd=6.58 ps=6.58 nrd=0.0966666666666667
+ nrs=0.0966666666666667 sa=0 sb=0 sd=0 mult=1 m=1
XM19 net3 net2 VSS VSS sky130_fd_pr__nfet_01v8_lvt L=1 W=3 nf=1 ad=0.87 as=0.87 pd=6.58 ps=6.58 nrd=0.0966666666666667
+ nrs=0.0966666666666667 sa=0 sb=0 sd=0 mult=1 m=1
XM20 net3 net2 VSS VSS sky130_fd_pr__nfet_01v8_lvt L=1 W=3 nf=1 ad=0.87 as=0.87 pd=6.58 ps=6.58 nrd=0.0966666666666667
+ nrs=0.0966666666666667 sa=0 sb=0 sd=0 mult=1 m=1
XM21 net3 net2 VSS VSS sky130_fd_pr__nfet_01v8_lvt L=1 W=3 nf=1 ad=0.87 as=0.87 pd=6.58 ps=6.58 nrd=0.0966666666666667
+ nrs=0.0966666666666667 sa=0 sb=0 sd=0 mult=1 m=1
XM22 net3 net2 VSS VSS sky130_fd_pr__nfet_01v8_lvt L=1 W=3 nf=1 ad=0.87 as=0.87 pd=6.58 ps=6.58 nrd=0.0966666666666667
+ nrs=0.0966666666666667 sa=0 sb=0 sd=0 mult=1 m=1
XM23 net3 net2 VSS VSS sky130_fd_pr__nfet_01v8_lvt L=1 W=3 nf=1 ad=0.87 as=0.87 pd=6.58 ps=6.58 nrd=0.0966666666666667
+ nrs=0.0966666666666667 sa=0 sb=0 sd=0 mult=1 m=1
XM24 net3 net2 VSS VSS sky130_fd_pr__nfet_01v8_lvt L=1 W=3 nf=1 ad=0.87 as=0.87 pd=6.58 ps=6.58 nrd=0.0966666666666667
+ nrs=0.0966666666666667 sa=0 sb=0 sd=0 mult=1 m=1
XM25 net3 net2 VSS VSS sky130_fd_pr__nfet_01v8_lvt L=1 W=3 nf=1 ad=0.87 as=0.87 pd=6.58 ps=6.58 nrd=0.0966666666666667
+ nrs=0.0966666666666667 sa=0 sb=0 sd=0 mult=1 m=1
XM26 net3 net2 VSS VSS sky130_fd_pr__nfet_01v8_lvt L=1 W=3 nf=1 ad=0.87 as=0.87 pd=6.58 ps=6.58 nrd=0.0966666666666667
+ nrs=0.0966666666666667 sa=0 sb=0 sd=0 mult=1 m=1
XM27 net3 net2 VSS VSS sky130_fd_pr__nfet_01v8_lvt L=1 W=3 nf=1 ad=0.87 as=0.87 pd=6.58 ps=6.58 nrd=0.0966666666666667
+ nrs=0.0966666666666667 sa=0 sb=0 sd=0 mult=1 m=1
XM28 net3 net2 VSS VSS sky130_fd_pr__nfet_01v8_lvt L=1 W=3 nf=1 ad=0.87 as=0.87 pd=6.58 ps=6.58 nrd=0.0966666666666667
+ nrs=0.0966666666666667 sa=0 sb=0 sd=0 mult=1 m=1
XM29 net3 net2 VSS VSS sky130_fd_pr__nfet_01v8_lvt L=1 W=3 nf=1 ad=0.87 as=0.87 pd=6.58 ps=6.58 nrd=0.0966666666666667
+ nrs=0.0966666666666667 sa=0 sb=0 sd=0 mult=1 m=1
XM30 VSS VSS VSS VSS sky130_fd_pr__nfet_01v8_lvt L=1 W=3 nf=1 ad=0.87 as=0.87 pd=6.58 ps=6.58 nrd=0.0966666666666667
+ nrs=0.0966666666666667 sa=0 sb=0 sd=0 mult=1 m=1
XM31 VSS VSS VSS VSS sky130_fd_pr__nfet_01v8_lvt L=1 W=3 nf=1 ad=0.87 as=0.87 pd=6.58 ps=6.58 nrd=0.0966666666666667
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
+ nrs=0.0414285714285714 sa=0 sb=0 sd=0 mult=1 m=1
XM144 VSS VSS VSS VSS sky130_fd_pr__nfet_01v8_lvt L=1 W=7 nf=1 ad=2.03 as=2.03 pd=14.58 ps=14.58 nrd=0.0414285714285714
+ nrs=0.0414285714285714 sa=0 sb=0 sd=0 mult=1 m=1
XM145 VSS VSS VSS VSS sky130_fd_pr__nfet_01v8_lvt L=1 W=7 nf=1 ad=2.03 as=2.03 pd=14.58 ps=14.58 nrd=0.0414285714285714
+ nrs=0.0414285714285714 sa=0 sb=0 sd=0 mult=1 m=1
XR1 net1 Vout1 VSS sky130_fd_pr__res_xhigh_po_1p41 L=14 mult=1 m=1
.ends
