lochidev/ttsky25_two_stage_opamp/xschem/post-layout/lvs/results/two_stage_opamp.spice

* NGSPICE file created from ttsky25_two_stage_opamp.ext - technology: sky130A

.subckt two_stage_opamp IBIAS EN VOUT VN VP VDD VSS
X0 VSS VSS VSS VSS sky130_fd_pr__nfet_01v8_lvt ad=1.015 pd=7.29 as=72.5 ps=531.32001 w=7 l=1
X1 VDD a_2479_7336# VOUT VDD sky130_fd_pr__pfet_01v8 ad=0.145 pd=1.29 as=0.145 ps=1.29 w=1 l=0.4
X2 VSS a_2080_2896# a_2080_2896# VSS sky130_fd_pr__nfet_01v8_lvt ad=0.435 pd=3.29 as=0.435 ps=3.29 w=3 l=1
X3 VDD a_2479_7336# VOUT VDD sky130_fd_pr__pfet_01v8 ad=0.145 pd=1.29 as=0.145 ps=1.29 w=1 l=0.4
X4 VDD VDD VDD VDD sky130_fd_pr__pfet_01v8 ad=0.145 pd=1.29 as=9.86 ps=87.72 w=1 l=0.4
X5 VSS a_2080_2896# a_4920_2896# VSS sky130_fd_pr__nfet_01v8_lvt ad=0.435 pd=3.29 as=0.435 ps=3.29 w=3 l=1
X6 VSS a_2080_2896# a_4920_2896# VSS sky130_fd_pr__nfet_01v8_lvt ad=0.435 pd=3.29 as=0.435 ps=3.29 w=3 l=1
X7 a_2479_7336# a_2479_7336# a_2479_7336# VSS sky130_fd_pr__nfet_01v8_lvt ad=1.015 pd=7.29 as=14.21 ps=102.06 w=7 l=1
X8 VSS VSS VSS VSS sky130_fd_pr__nfet_01v8_lvt ad=1.015 pd=7.29 as=0 ps=0 w=7 l=1
X9 VDD VDD VDD VDD sky130_fd_pr__pfet_01v8 ad=0.145 pd=1.29 as=0 ps=0 w=1 l=0.4
X10 VDD a_2479_7336# VOUT VDD sky130_fd_pr__pfet_01v8 ad=0.145 pd=1.29 as=0.145 ps=1.29 w=1 l=0.4
X11 VDD a_2479_7336# VOUT VDD sky130_fd_pr__pfet_01v8 ad=0.145 pd=1.29 as=0.145 ps=1.29 w=1 l=0.4
X12 a_4920_2896# a_2080_2896# VSS VSS sky130_fd_pr__nfet_01v8_lvt ad=0.435 pd=3.29 as=0.435 ps=3.29 w=3 l=1
X13 a_2479_7336# a_2479_7336# a_2479_7336# VSS sky130_fd_pr__nfet_01v8_lvt ad=2.03 pd=14.58 as=0 ps=0 w=7 l=1
X14 a_2479_7336# VP a_2995_7336# VSS sky130_fd_pr__nfet_01v8_lvt ad=1.015 pd=7.29 as=1.015 ps=7.29 w=7 l=1
X15 VSS a_2080_2896# a_4920_2896# VSS sky130_fd_pr__nfet_01v8_lvt ad=0.435 pd=3.29 as=0.435 ps=3.29 w=3 l=1
X16 VSS VSS VSS VSS sky130_fd_pr__nfet_01v8_lvt ad=0.435 pd=3.29 as=0 ps=0 w=3 l=1
X17 a_2995_7336# VN a_2479_9004# VSS sky130_fd_pr__nfet_01v8_lvt ad=1.015 pd=7.29 as=1.015 ps=7.29 w=7 l=1
X18 VDD a_2479_7336# VOUT VDD sky130_fd_pr__pfet_01v8 ad=0.145 pd=1.29 as=0.145 ps=1.29 w=1 l=0.4
X19 a_2479_9004# VN a_2995_7336# VSS sky130_fd_pr__nfet_01v8_lvt ad=1.015 pd=7.29 as=1.015 ps=7.29 w=7 l=1
X20 VSS VSS VSS VSS sky130_fd_pr__nfet_01v8_lvt ad=0.435 pd=3.29 as=0 ps=0 w=3 l=1
X21 a_2479_9004# a_2479_9004# a_2479_9004# VSS sky130_fd_pr__nfet_01v8_lvt ad=1.015 pd=7.29 as=14.21 ps=102.06 w=7 l=1
X22 VSS VSS VSS VSS sky130_fd_pr__nfet_01v8_lvt ad=0.435 pd=3.29 as=0 ps=0 w=3 l=1
X23 a_4920_2896# a_2080_2896# VSS VSS sky130_fd_pr__nfet_01v8_lvt ad=0.435 pd=3.29 as=0.435 ps=3.29 w=3 l=1
X24 a_2479_9004# a_2479_9004# a_2479_9004# VSS sky130_fd_pr__nfet_01v8_lvt ad=2.03 pd=14.58 as=0 ps=0 w=7 l=1
X25 a_2479_9004# VN a_2995_7336# VSS sky130_fd_pr__nfet_01v8_lvt ad=1.015 pd=7.29 as=1.015 ps=7.29 w=7 l=1
X26 VSS a_2080_2896# a_4920_2896# VSS sky130_fd_pr__nfet_01v8_lvt ad=0.435 pd=3.29 as=0.435 ps=3.29 w=3 l=1
X27 VOUT a_2479_7336# VDD VDD sky130_fd_pr__pfet_01v8 ad=0.145 pd=1.29 as=0.145 ps=1.29 w=1 l=0.4
X28 VSS VSS VSS VSS sky130_fd_pr__nfet_01v8_lvt ad=1.015 pd=7.29 as=0 ps=0 w=7 l=1
X29 VDD VDD VDD VDD sky130_fd_pr__pfet_01v8 ad=0.145 pd=1.29 as=0 ps=0 w=1 l=0.4
X30 a_2995_7336# VP a_2479_7336# VSS sky130_fd_pr__nfet_01v8_lvt ad=1.015 pd=7.29 as=1.015 ps=7.29 w=7 l=1
X31 VSS VSS VSS VSS sky130_fd_pr__nfet_01v8_lvt ad=1.015 pd=7.29 as=0 ps=0 w=7 l=1
X32 a_3758_2896# a_2080_2896# VSS VSS sky130_fd_pr__nfet_01v8_lvt ad=0.435 pd=3.29 as=0.435 ps=3.29 w=3 l=1
X33 a_4920_2896# a_2080_2896# VSS VSS sky130_fd_pr__nfet_01v8_lvt ad=0.435 pd=3.29 as=0.435 ps=3.29 w=3 l=1
X34 a_2479_7336# VP a_2995_7336# VSS sky130_fd_pr__nfet_01v8_lvt ad=1.015 pd=7.29 as=1.015 ps=7.29 w=7 l=1
X35 a_3758_2896# a_2080_2896# VSS VSS sky130_fd_pr__nfet_01v8_lvt ad=0.435 pd=3.29 as=0.435 ps=3.29 w=3 l=1
X36 VOUT a_2479_7336# VDD VDD sky130_fd_pr__pfet_01v8 ad=0.145 pd=1.29 as=0.145 ps=1.29 w=1 l=0.4
X37 VSS a_2080_2896# a_3758_2896# VSS sky130_fd_pr__nfet_01v8_lvt ad=0.435 pd=3.29 as=0.435 ps=3.29 w=3 l=1
X38 a_4920_2896# a_4920_2896# a_4920_2896# VSS sky130_fd_pr__nfet_01v8_lvt ad=1.015 pd=7.29 as=14.5 ps=108.12 w=7 l=1
X39 a_4920_2896# a_2080_2896# VSS VSS sky130_fd_pr__nfet_01v8_lvt ad=0.435 pd=3.29 as=0.435 ps=3.29 w=3 l=1
X40 a_3758_2896# a_2080_2896# VSS VSS sky130_fd_pr__nfet_01v8_lvt ad=0.435 pd=3.29 as=0.435 ps=3.29 w=3 l=1
X41 a_3758_2896# a_2080_2896# VSS VSS sky130_fd_pr__nfet_01v8_lvt ad=0.435 pd=3.29 as=0.435 ps=3.29 w=3 l=1
X42 a_4920_2896# EN VOUT VSS sky130_fd_pr__nfet_01v8_lvt ad=1.015 pd=7.29 as=1.015 ps=7.29 w=7 l=1
X43 a_2995_7336# VP a_2479_7336# VSS sky130_fd_pr__nfet_01v8_lvt ad=1.015 pd=7.29 as=1.015 ps=7.29 w=7 l=1
X44 VDD a_2479_9004# a_2479_9004# VDD sky130_fd_pr__pfet_01v8 ad=0.145 pd=1.29 as=0.145 ps=1.29 w=1 l=0.4
X45 VOUT VOUT VOUT VSS sky130_fd_pr__nfet_01v8_lvt ad=2.03 pd=14.58 as=4.06 ps=29.16 w=7 l=1
X46 a_4920_2896# a_2080_2896# VSS VSS sky130_fd_pr__nfet_01v8_lvt ad=0.435 pd=3.29 as=0.435 ps=3.29 w=3 l=1
X47 VDD VDD VDD VDD sky130_fd_pr__pfet_01v8 ad=0.145 pd=1.29 as=0 ps=0 w=1 l=0.4
X48 VSS a_2080_2896# a_4920_2896# VSS sky130_fd_pr__nfet_01v8_lvt ad=0.435 pd=3.29 as=0.435 ps=3.29 w=3 l=1
X49 VDD VDD VDD VDD sky130_fd_pr__pfet_01v8 ad=0.145 pd=1.29 as=0 ps=0 w=1 l=0.4
X50 VSS VSS VSS VSS sky130_fd_pr__nfet_01v8_lvt ad=1.015 pd=7.29 as=0 ps=0 w=7 l=1
X51 VDD a_2479_7336# VOUT VDD sky130_fd_pr__pfet_01v8 ad=0.145 pd=1.29 as=0.145 ps=1.29 w=1 l=0.4
X52 VSS VSS VSS VSS sky130_fd_pr__nfet_01v8_lvt ad=0.87 pd=6.58 as=0 ps=0 w=3 l=1
X53 VSS VSS VSS VSS sky130_fd_pr__nfet_01v8_lvt ad=1.015 pd=7.29 as=0 ps=0 w=7 l=1
X54 VOUT VOUT VOUT VDD sky130_fd_pr__pfet_01v8 ad=0.29 pd=2.58 as=4.06 ps=36.12 w=1 l=0.4
X55 VSS a_2080_2896# a_4920_2896# VSS sky130_fd_pr__nfet_01v8_lvt ad=0.435 pd=3.29 as=0.435 ps=3.29 w=3 l=1
X56 VOUT VOUT VOUT VDD sky130_fd_pr__pfet_01v8 ad=0.145 pd=1.29 as=0 ps=0 w=1 l=0.4
X57 a_2995_7336# VN a_2479_9004# VSS sky130_fd_pr__nfet_01v8_lvt ad=1.015 pd=7.29 as=1.015 ps=7.29 w=7 l=1
X58 VDD a_2479_7336# VOUT VDD sky130_fd_pr__pfet_01v8 ad=0.145 pd=1.29 as=0.145 ps=1.29 w=1 l=0.4
X59 VSS VSS VSS VSS sky130_fd_pr__nfet_01v8_lvt ad=2.03 pd=14.58 as=0 ps=0 w=7 l=1
X60 VDD VDD VDD VDD sky130_fd_pr__pfet_01v8 ad=0.29 pd=2.58 as=0 ps=0 w=1 l=0.4
X61 a_2479_9004# a_2479_9004# VDD VDD sky130_fd_pr__pfet_01v8 ad=0.145 pd=1.29 as=0.145 ps=1.29 w=1 l=0.4
X62 C1 VOUT sky130_fd_pr__cap_mim_m3_1 l=25.5 w=25.5
X63 VDD a_2479_7336# VOUT VDD sky130_fd_pr__pfet_01v8 ad=0.145 pd=1.29 as=0.145 ps=1.29 w=1 l=0.4
X64 VSS a_2080_2896# a_3758_2896# VSS sky130_fd_pr__nfet_01v8_lvt ad=0.435 pd=3.29 as=0.435 ps=3.29 w=3 l=1
X65 a_4920_2896# a_2080_2896# VSS VSS sky130_fd_pr__nfet_01v8_lvt ad=0.435 pd=3.29 as=0.435 ps=3.29 w=3 l=1
X66 VSS VSS VSS VSS sky130_fd_pr__nfet_01v8_lvt ad=1.015 pd=7.29 as=0 ps=0 w=7 l=1
X67 VOUT a_2479_7336# VDD VDD sky130_fd_pr__pfet_01v8 ad=0.145 pd=1.29 as=0.145 ps=1.29 w=1 l=0.4
X68 VDD a_2479_9004# a_2479_7336# VDD sky130_fd_pr__pfet_01v8 ad=0.145 pd=1.29 as=0.145 ps=1.29 w=1 l=0.4
X69 VDD VDD VDD VDD sky130_fd_pr__pfet_01v8 ad=0.145 pd=1.29 as=0 ps=0 w=1 l=0.4
X70 VSS VSS VSS VSS sky130_fd_pr__nfet_01v8_lvt ad=1.015 pd=7.29 as=0 ps=0 w=7 l=1
X71 VDD VDD VDD VDD sky130_fd_pr__pfet_01v8 ad=0.145 pd=1.29 as=0 ps=0 w=1 l=0.4
X72 VOUT a_2479_7336# VDD VDD sky130_fd_pr__pfet_01v8 ad=0.145 pd=1.29 as=0.145 ps=1.29 w=1 l=0.4
X73 VSS a_2080_2896# a_3758_2896# VSS sky130_fd_pr__nfet_01v8_lvt ad=0.435 pd=3.29 as=0.435 ps=3.29 w=3 l=1
X74 VSS VSS VSS VSS sky130_fd_pr__nfet_01v8_lvt ad=1.015 pd=7.29 as=0 ps=0 w=7 l=1
X75 VDD VDD VDD VDD sky130_fd_pr__pfet_01v8 ad=0.145 pd=1.29 as=0 ps=0 w=1 l=0.4
X76 VSS VSS VSS VSS sky130_fd_pr__nfet_01v8_lvt ad=1.015 pd=7.29 as=0 ps=0 w=7 l=1
X77 VDD VDD VDD VDD sky130_fd_pr__pfet_01v8 ad=0.145 pd=1.29 as=0 ps=0 w=1 l=0.4
X78 a_3758_2896# a_2080_2896# VSS VSS sky130_fd_pr__nfet_01v8_lvt ad=0.435 pd=3.29 as=0.435 ps=3.29 w=3 l=1
X79 VSS VSS VSS VSS sky130_fd_pr__nfet_01v8_lvt ad=1.015 pd=7.29 as=0 ps=0 w=7 l=1
X80 VSS VSS VSS VSS sky130_fd_pr__nfet_01v8_lvt ad=1.015 pd=7.29 as=0 ps=0 w=7 l=1
X81 VSS VSS VSS VSS sky130_fd_pr__nfet_01v8_lvt ad=0.435 pd=3.29 as=0 ps=0 w=3 l=1
X82 a_2995_7336# VP a_2479_7336# VSS sky130_fd_pr__nfet_01v8_lvt ad=1.015 pd=7.29 as=1.015 ps=7.29 w=7 l=1
X83 VSS VSS VSS VSS sky130_fd_pr__nfet_01v8_lvt ad=0.435 pd=3.29 as=0 ps=0 w=3 l=1
X84 a_4920_2896# a_2080_2896# VSS VSS sky130_fd_pr__nfet_01v8_lvt ad=0.435 pd=3.29 as=0.435 ps=3.29 w=3 l=1
X85 a_2479_7336# VP a_2995_7336# VSS sky130_fd_pr__nfet_01v8_lvt ad=1.015 pd=7.29 as=1.015 ps=7.29 w=7 l=1
X86 a_2080_2896# a_2080_2896# a_2080_2896# VSS sky130_fd_pr__nfet_01v8_lvt ad=2.03 pd=14.58 as=4.93 ps=35.74 w=7 l=1
X87 a_2479_7336# a_2479_9004# VDD VDD sky130_fd_pr__pfet_01v8 ad=0.145 pd=1.29 as=0.145 ps=1.29 w=1 l=0.4
X88 VSS a_2080_2896# a_4920_2896# VSS sky130_fd_pr__nfet_01v8_lvt ad=0.435 pd=3.29 as=0.435 ps=3.29 w=3 l=1
X89 a_2995_7336# VN a_2479_9004# VSS sky130_fd_pr__nfet_01v8_lvt ad=1.015 pd=7.29 as=1.015 ps=7.29 w=7 l=1
X90 VOUT a_2479_7336# VDD VDD sky130_fd_pr__pfet_01v8 ad=0.145 pd=1.29 as=0.145 ps=1.29 w=1 l=0.4
X91 a_4920_2896# a_2080_2896# VSS VSS sky130_fd_pr__nfet_01v8_lvt ad=0.435 pd=3.29 as=0.435 ps=3.29 w=3 l=1
X92 a_2479_9004# VN a_2995_7336# VSS sky130_fd_pr__nfet_01v8_lvt ad=1.015 pd=7.29 as=1.015 ps=7.29 w=7 l=1
X93 VDD a_2479_9004# a_2479_7336# VDD sky130_fd_pr__pfet_01v8 ad=0.145 pd=1.29 as=0.145 ps=1.29 w=1 l=0.4
X94 VDD VDD VDD VDD sky130_fd_pr__pfet_01v8 ad=0.145 pd=1.29 as=0 ps=0 w=1 l=0.4
X95 VSS a_2080_2896# a_4920_2896# VSS sky130_fd_pr__nfet_01v8_lvt ad=0.435 pd=3.29 as=0.435 ps=3.29 w=3 l=1
X96 VOUT a_2479_7336# VDD VDD sky130_fd_pr__pfet_01v8 ad=0.145 pd=1.29 as=0.145 ps=1.29 w=1 l=0.4
X97 VSS a_2080_2896# a_4920_2896# VSS sky130_fd_pr__nfet_01v8_lvt ad=0.435 pd=3.29 as=0.435 ps=3.29 w=3 l=1
X98 a_2995_7336# VN a_2479_9004# VSS sky130_fd_pr__nfet_01v8_lvt ad=1.015 pd=7.29 as=1.015 ps=7.29 w=7 l=1
X99 VDD VDD VDD VDD sky130_fd_pr__pfet_01v8 ad=0.145 pd=1.29 as=0 ps=0 w=1 l=0.4
X100 a_4920_2896# a_2080_2896# VSS VSS sky130_fd_pr__nfet_01v8_lvt ad=0.435 pd=3.29 as=0.435 ps=3.29 w=3 l=1
X101 a_2479_9004# VN a_2995_7336# VSS sky130_fd_pr__nfet_01v8_lvt ad=1.015 pd=7.29 as=1.015 ps=7.29 w=7 l=1
X102 VSS a_2080_2896# a_4920_2896# VSS sky130_fd_pr__nfet_01v8_lvt ad=0.435 pd=3.29 as=0.435 ps=3.29 w=3 l=1
X103 VSS VSS VSS VSS sky130_fd_pr__nfet_01v8_lvt ad=0.435 pd=3.29 as=0 ps=0 w=3 l=1
X104 a_2995_7336# VP a_2479_7336# VSS sky130_fd_pr__nfet_01v8_lvt ad=1.015 pd=7.29 as=1.015 ps=7.29 w=7 l=1
X105 a_2479_7336# VP a_2995_7336# VSS sky130_fd_pr__nfet_01v8_lvt ad=1.015 pd=7.29 as=1.015 ps=7.29 w=7 l=1
X106 VSS VSS VSS VSS sky130_fd_pr__nfet_01v8_lvt ad=0.435 pd=3.29 as=0 ps=0 w=3 l=1
X107 VSS a_2080_2896# a_3758_2896# VSS sky130_fd_pr__nfet_01v8_lvt ad=0.435 pd=3.29 as=0.435 ps=3.29 w=3 l=1
X108 VSS a_2080_2896# a_3758_2896# VSS sky130_fd_pr__nfet_01v8_lvt ad=0.435 pd=3.29 as=0.435 ps=3.29 w=3 l=1
X109 VSS VSS VSS VSS sky130_fd_pr__nfet_01v8_lvt ad=0.87 pd=6.58 as=0 ps=0 w=3 l=1
X110 a_3758_2896# a_2080_2896# VSS VSS sky130_fd_pr__nfet_01v8_lvt ad=0.435 pd=3.29 as=0.435 ps=3.29 w=3 l=1
X111 VDD a_2479_9004# a_2479_9004# VDD sky130_fd_pr__pfet_01v8 ad=0.145 pd=1.29 as=0.145 ps=1.29 w=1 l=0.4
X112 VSS a_2080_2896# a_3758_2896# VSS sky130_fd_pr__nfet_01v8_lvt ad=0.435 pd=3.29 as=0.435 ps=3.29 w=3 l=1
X113 IBIAS IBIAS IBIAS VSS sky130_fd_pr__nfet_01v8_lvt ad=1.015 pd=7.29 as=4.06 ps=29.16 w=7 l=1
X114 VSS VSS VSS VSS sky130_fd_pr__nfet_01v8_lvt ad=1.015 pd=7.29 as=0 ps=0 w=7 l=1
X115 VDD VDD VDD VDD sky130_fd_pr__pfet_01v8 ad=0.145 pd=1.29 as=0 ps=0 w=1 l=0.4
X116 VSS a_2080_2896# a_4920_2896# VSS sky130_fd_pr__nfet_01v8_lvt ad=0.435 pd=3.29 as=0.435 ps=3.29 w=3 l=1
X117 VDD VDD VDD VDD sky130_fd_pr__pfet_01v8 ad=0.29 pd=2.58 as=0 ps=0 w=1 l=0.4
X118 IBIAS EN a_2080_2896# VSS sky130_fd_pr__nfet_01v8_lvt ad=1.015 pd=7.29 as=1.015 ps=7.29 w=7 l=1
X119 VSS VSS VSS VSS sky130_fd_pr__nfet_01v8_lvt ad=1.015 pd=7.29 as=0 ps=0 w=7 l=1
X120 a_2479_7336# a_2479_9004# VDD VDD sky130_fd_pr__pfet_01v8 ad=0.145 pd=1.29 as=0.145 ps=1.29 w=1 l=0.4
X121 a_4920_2896# a_2080_2896# VSS VSS sky130_fd_pr__nfet_01v8_lvt ad=0.435 pd=3.29 as=0.435 ps=3.29 w=3 l=1
X122 a_4920_2896# a_2080_2896# VSS VSS sky130_fd_pr__nfet_01v8_lvt ad=0.435 pd=3.29 as=0.435 ps=3.29 w=3 l=1
X123 VOUT a_2479_7336# VDD VDD sky130_fd_pr__pfet_01v8 ad=0.145 pd=1.29 as=0.145 ps=1.29 w=1 l=0.4
X124 a_2479_7336# C1 VSS sky130_fd_pr__res_xhigh_po_1p41 l=14
X125 VDD VDD VDD VDD sky130_fd_pr__pfet_01v8 ad=0.145 pd=1.29 as=0 ps=0 w=1 l=0.4
X126 VDD VDD VDD VDD sky130_fd_pr__pfet_01v8 ad=0.145 pd=1.29 as=0 ps=0 w=1 l=0.4
X127 a_3758_2896# a_3758_2896# a_3758_2896# VSS sky130_fd_pr__nfet_01v8_lvt ad=1.015 pd=7.29 as=9.28 ps=68.64 w=7 l=1
X128 VOUT a_2479_7336# VDD VDD sky130_fd_pr__pfet_01v8 ad=0.145 pd=1.29 as=0.145 ps=1.29 w=1 l=0.4
X129 VOUT VOUT VOUT VDD sky130_fd_pr__pfet_01v8 ad=0.145 pd=1.29 as=0 ps=0 w=1 l=0.4
X130 a_4920_2896# a_2080_2896# VSS VSS sky130_fd_pr__nfet_01v8_lvt ad=0.435 pd=3.29 as=0.435 ps=3.29 w=3 l=1
X131 a_3758_2896# EN a_2995_7336# VSS sky130_fd_pr__nfet_01v8_lvt ad=1.015 pd=7.29 as=1.015 ps=7.29 w=7 l=1
X132 VSS a_2080_2896# a_4920_2896# VSS sky130_fd_pr__nfet_01v8_lvt ad=0.435 pd=3.29 as=0.435 ps=3.29 w=3 l=1
X133 VOUT VOUT VOUT VDD sky130_fd_pr__pfet_01v8 ad=0.145 pd=1.29 as=0 ps=0 w=1 l=0.4
X134 VOUT a_2479_7336# VDD VDD sky130_fd_pr__pfet_01v8 ad=0.145 pd=1.29 as=0.145 ps=1.29 w=1 l=0.4
X135 VSS VSS VSS VSS sky130_fd_pr__nfet_01v8_lvt ad=0.87 pd=6.58 as=0 ps=0 w=3 l=1
X136 a_2995_7336# a_2995_7336# a_2995_7336# VSS sky130_fd_pr__nfet_01v8_lvt ad=2.03 pd=14.58 as=20.3 ps=145.8 w=7 l=1
X137 VDD VDD VDD VDD sky130_fd_pr__pfet_01v8 ad=0.145 pd=1.29 as=0 ps=0 w=1 l=0.4
X138 VSS VSS VSS VSS sky130_fd_pr__nfet_01v8_lvt ad=1.015 pd=7.29 as=0 ps=0 w=7 l=1
X139 VDD VDD VDD VDD sky130_fd_pr__pfet_01v8 ad=0.29 pd=2.58 as=0 ps=0 w=1 l=0.4
X140 a_2080_2896# a_2080_2896# VSS VSS sky130_fd_pr__nfet_01v8_lvt ad=0.435 pd=3.29 as=0.435 ps=3.29 w=3 l=1
X141 VSS VSS VSS VSS sky130_fd_pr__nfet_01v8_lvt ad=2.03 pd=14.58 as=0 ps=0 w=7 l=1
X142 VSS VSS VSS VSS sky130_fd_pr__nfet_01v8_lvt ad=1.015 pd=7.29 as=0 ps=0 w=7 l=1
X143 VDD a_2479_7336# VOUT VDD sky130_fd_pr__pfet_01v8 ad=0.145 pd=1.29 as=0.145 ps=1.29 w=1 l=0.4
X144 VSS VSS VSS VSS sky130_fd_pr__nfet_01v8_lvt ad=1.015 pd=7.29 as=0 ps=0 w=7 l=1
X145 a_2479_9004# a_2479_9004# VDD VDD sky130_fd_pr__pfet_01v8 ad=0.145 pd=1.29 as=0.145 ps=1.29 w=1 l=0.4
X146 VSS VSS VSS VSS sky130_fd_pr__nfet_01v8_lvt ad=1.015 pd=7.29 as=0 ps=0 w=7 l=1
.ends
