lochidev/ttsky25_two_stage_opamp/xschem/post-layout/lvs/results/two_stage_op_amp_lvs.spice

** sch_path: /foss/designs/ttsky25_two_stage_opamp/xschem/post-layout/lvs/src/two_stage_op_amp_lvs.sch
.subckt two_stage_op_amp_lvs VSS VDD IBIAS VOUT EN VN VP
*.PININFO VSS:B VDD:B IBIAS:B VOUT:O EN:B VN:B VP:B
XC2 net1 VOUT sky130_fd_pr__cap_mim_m3_1 W=16 L=16 m=1
XM5 net2 net2 net2 VSS sky130_fd_pr__nfet_01v8_lvt L=1 W=7 nf=1 m=1
XM6 IBIAS EN net2 VSS sky130_fd_pr__nfet_01v8_lvt L=1 W=7 nf=1 m=1
XM8 IBIAS IBIAS IBIAS VSS sky130_fd_pr__nfet_01v8_lvt L=1 W=7 nf=1 m=1
XM9 Vz Vz Vz VSS sky130_fd_pr__nfet_01v8_lvt L=1 W=7 nf=1 m=1
XM10 Vz EN net3 VSS sky130_fd_pr__nfet_01v8_lvt L=1 W=7 nf=1 m=1
XM11 net3 net3 net3 VSS sky130_fd_pr__nfet_01v8_lvt L=1 W=7 nf=1 m=1
XM13 VOUT EN net4 VSS sky130_fd_pr__nfet_01v8_lvt L=1 W=7 nf=1 m=1
XM14 VOUT VOUT VOUT VSS sky130_fd_pr__nfet_01v8_lvt L=1 W=7 nf=1 m=1
XM15 VOUT VOUT VOUT VSS sky130_fd_pr__nfet_01v8_lvt L=1 W=7 nf=1 m=1
XM16 net2 net2 VSS VSS sky130_fd_pr__nfet_01v8_lvt L=1 W=3 nf=1 m=1
XM17 net2 net2 VSS VSS sky130_fd_pr__nfet_01v8_lvt L=1 W=3 nf=1 m=1
XM18 net3 net2 VSS VSS sky130_fd_pr__nfet_01v8_lvt L=1 W=3 nf=1 m=1
XM19 net3 net2 VSS VSS sky130_fd_pr__nfet_01v8_lvt L=1 W=3 nf=1 m=1
XM20 net3 net2 VSS VSS sky130_fd_pr__nfet_01v8_lvt L=1 W=3 nf=1 m=1
XM21 net3 net2 VSS VSS sky130_fd_pr__nfet_01v8_lvt L=1 W=3 nf=1 m=1
XM22 net3 net2 VSS VSS sky130_fd_pr__nfet_01v8_lvt L=1 W=3 nf=1 m=1
XM23 net3 net2 VSS VSS sky130_fd_pr__nfet_01v8_lvt L=1 W=3 nf=1 m=1
XM24 net3 net2 VSS VSS sky130_fd_pr__nfet_01v8_lvt L=1 W=3 nf=1 m=1
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
XM131 VSS VSS VSS VSS sky130_fd_pr__nfet_01v8_lvt L=1 W=7 nf=1 m=1
XM132 VSS VSS VSS VSS sky130_fd_pr__nfet_01v8_lvt L=1 W=7 nf=1 m=1
XM133 VSS VSS VSS VSS sky130_fd_pr__nfet_01v8_lvt L=1 W=7 nf=1 m=1
XM134 VSS VSS VSS VSS sky130_fd_pr__nfet_01v8_lvt L=1 W=7 nf=1 m=1
XM135 VSS VSS VSS VSS sky130_fd_pr__nfet_01v8_lvt L=1 W=7 nf=1 m=1
XM136 VSS VSS VSS VSS sky130_fd_pr__nfet_01v8_lvt L=1 W=7 nf=1 m=1
XM137 VSS VSS VSS VSS sky130_fd_pr__nfet_01v8_lvt L=1 W=7 nf=1 m=1
XM138 VSS VSS VSS VSS sky130_fd_pr__nfet_01v8_lvt L=1 W=7 nf=1 m=1
XM139 VSS VSS VSS VSS sky130_fd_pr__nfet_01v8_lvt L=1 W=7 nf=1 m=1
XM140 VSS VSS VSS VSS sky130_fd_pr__nfet_01v8_lvt L=1 W=7 nf=1 m=1
XM141 VSS VSS VSS VSS sky130_fd_pr__nfet_01v8_lvt L=1 W=7 nf=1 m=1
XM142 VSS VSS VSS VSS sky130_fd_pr__nfet_01v8_lvt L=1 W=7 nf=1 m=1
XM143 VSS VSS VSS VSS sky130_fd_pr__nfet_01v8_lvt L=1 W=7 nf=1 m=1
XM144 VSS VSS VSS VSS sky130_fd_pr__nfet_01v8_lvt L=1 W=7 nf=1 m=1
XM145 VSS VSS VSS VSS sky130_fd_pr__nfet_01v8_lvt L=1 W=7 nf=1 m=1
XR1 net1 Vout1 VSS sky130_fd_pr__res_xhigh_po_1p41 L=14 mult=1 m=1
XM122 Vpo VN Vz VSS sky130_fd_pr__nfet_01v8_lvt L=1 W=7 nf=1 m=1
XM123 Vz VSS VSS VSS sky130_fd_pr__nfet_01v8_lvt L=1 W=7 nf=1 m=1
XM124 Vout1 VP Vz VSS sky130_fd_pr__nfet_01v8_lvt L=1 W=7 nf=1 m=1
XM125 Vz VSS VSS VSS sky130_fd_pr__nfet_01v8_lvt L=1 W=7 nf=1 m=1
XM146 Vpo VN Vz VSS sky130_fd_pr__nfet_01v8_lvt L=1 W=7 nf=1 m=1
XM147 Vout1 VP Vz VSS sky130_fd_pr__nfet_01v8_lvt L=1 W=7 nf=1 m=1
XM148 Vz VSS VSS VSS sky130_fd_pr__nfet_01v8_lvt L=1 W=7 nf=1 m=1
XM149 Vz VSS VSS VSS sky130_fd_pr__nfet_01v8_lvt L=1 W=7 nf=1 m=1
XM150 VOUT EN net4 VSS sky130_fd_pr__nfet_01v8_lvt L=1 W=7 nf=1 m=1
XM151 VSS VSS VSS VSS sky130_fd_pr__nfet_01v8_lvt L=1 W=7 nf=1 m=1
XM152 VSS VSS VSS VSS sky130_fd_pr__nfet_01v8_lvt L=1 W=7 nf=1 m=1
XM153 VSS VSS VSS VSS sky130_fd_pr__nfet_01v8_lvt L=1 W=7 nf=1 m=1
XM154 VSS VSS VSS VSS sky130_fd_pr__nfet_01v8_lvt L=1 W=7 nf=1 m=1
.ends
