lochidev/ttsky25_two_stage_opamp/netlist/rcx/ttsky25_two_stage_opamp.spice

* NGSPICE file created from ttsky25_two_stage_opamp.ext - technology: sky130A

.subckt ttsky25_two_stage_opamp VDD IBIAS VOUT VN VP EN VSS
X0 VSS.t132 VSS.t131 VSS.t132 VSS.t8 sky130_fd_pr__nfet_01v8_lvt ad=1.015 pd=7.29 as=0 ps=0 w=7 l=1
X1 VDD.t74 a_2479_7336.t18 VOUT.t26 VDD.t2 sky130_fd_pr__pfet_01v8 ad=0.145 pd=1.29 as=0.145 ps=1.29 w=1 l=0.4
X2 VSS.t58 a_2080_2896.t5 a_2080_2896.t6 VSS.t14 sky130_fd_pr__nfet_01v8_lvt ad=0.435 pd=3.29 as=0.435 ps=3.29 w=3 l=1
X3 VDD.t73 a_2479_7336.t19 VOUT.t24 VDD.t31 sky130_fd_pr__pfet_01v8 ad=0.145 pd=1.29 as=0.145 ps=1.29 w=1 l=0.4
X4 VDD.t55 VDD.t54 VDD.t55 VDD.t50 sky130_fd_pr__pfet_01v8 ad=0.145 pd=1.29 as=0 ps=0 w=1 l=0.4
X5 VSS.t39 a_2080_2896.t8 a_4920_2896.t23 VSS.t38 sky130_fd_pr__nfet_01v8_lvt ad=0.435 pd=3.29 as=0.435 ps=3.29 w=3 l=1
X6 VSS.t17 a_2080_2896.t9 a_4920_2896.t22 VSS.t16 sky130_fd_pr__nfet_01v8_lvt ad=0.435 pd=3.29 as=0.435 ps=3.29 w=3 l=1
X7 a_2479_7336.t14 a_2479_7336.t13 a_2479_7336.t14 VSS.t30 sky130_fd_pr__nfet_01v8_lvt ad=1.015 pd=7.29 as=0 ps=0 w=7 l=1
X8 VSS.t130 VSS.t129 VSS.t130 VSS.t22 sky130_fd_pr__nfet_01v8_lvt ad=1.015 pd=7.29 as=0 ps=0 w=7 l=1
X9 VDD.t53 VDD.t52 VDD.t53 VDD.t17 sky130_fd_pr__pfet_01v8 ad=0.145 pd=1.29 as=0 ps=0 w=1 l=0.4
X10 VDD.t72 a_2479_7336.t20 VOUT.t25 VDD.t28 sky130_fd_pr__pfet_01v8 ad=0.145 pd=1.29 as=0.145 ps=1.29 w=1 l=0.4
X11 VDD.t71 a_2479_7336.t21 VOUT.t18 VDD.t31 sky130_fd_pr__pfet_01v8 ad=0.145 pd=1.29 as=0.145 ps=1.29 w=1 l=0.4
X12 a_4920_2896.t21 a_2080_2896.t10 VSS.t64 VSS.t53 sky130_fd_pr__nfet_01v8_lvt ad=0.435 pd=3.29 as=0.435 ps=3.29 w=3 l=1
X13 a_2479_7336.t12 a_2479_7336.t10 a_2479_7336.t11 VSS.t2 sky130_fd_pr__nfet_01v8_lvt ad=2.03 pd=14.58 as=0 ps=0 w=7 l=1
X14 a_2479_7336.t7 VP.t0 a_2995_7336.t14 VSS.t43 sky130_fd_pr__nfet_01v8_lvt ad=1.015 pd=7.29 as=1.015 ps=7.29 w=7 l=1
X15 VSS.t56 a_2080_2896.t11 a_4920_2896.t20 VSS.t55 sky130_fd_pr__nfet_01v8_lvt ad=0.435 pd=3.29 as=0.435 ps=3.29 w=3 l=1
X16 VSS.t128 VSS.t127 VSS.t128 VSS.t91 sky130_fd_pr__nfet_01v8_lvt ad=0.435 pd=3.29 as=0 ps=0 w=3 l=1
X17 a_2995_7336.t2 VN.t0 a_2479_9004.t20 VSS.t9 sky130_fd_pr__nfet_01v8_lvt ad=1.015 pd=7.29 as=1.015 ps=7.29 w=7 l=1
X18 VDD.t70 a_2479_7336.t22 VOUT.t15 VDD.t28 sky130_fd_pr__pfet_01v8 ad=0.145 pd=1.29 as=0.145 ps=1.29 w=1 l=0.4
X19 a_2479_9004.t19 VN.t1 a_2995_7336.t6 VSS.t8 sky130_fd_pr__nfet_01v8_lvt ad=1.015 pd=7.29 as=1.015 ps=7.29 w=7 l=1
X20 VSS.t126 VSS.t125 VSS.t126 VSS.t88 sky130_fd_pr__nfet_01v8_lvt ad=0.435 pd=3.29 as=0 ps=0 w=3 l=1
X21 a_2479_9004.t12 a_2479_9004.t11 a_2479_9004.t12 VSS.t30 sky130_fd_pr__nfet_01v8_lvt ad=1.015 pd=7.29 as=0 ps=0 w=7 l=1
X22 VSS.t124 VSS.t123 VSS.t124 VSS.t36 sky130_fd_pr__nfet_01v8_lvt ad=0.435 pd=3.29 as=0 ps=0 w=3 l=1
X23 a_4920_2896.t19 a_2080_2896.t12 VSS.t47 VSS.t3 sky130_fd_pr__nfet_01v8_lvt ad=0.435 pd=3.29 as=0.435 ps=3.29 w=3 l=1
X24 a_2479_9004.t10 a_2479_9004.t8 a_2479_9004.t9 VSS.t2 sky130_fd_pr__nfet_01v8_lvt ad=2.03 pd=14.58 as=0 ps=0 w=7 l=1
X25 a_2479_9004.t18 VN.t2 a_2995_7336.t16 VSS.t43 sky130_fd_pr__nfet_01v8_lvt ad=1.015 pd=7.29 as=1.015 ps=7.29 w=7 l=1
X26 VSS.t29 a_2080_2896.t13 a_4920_2896.t18 VSS.t24 sky130_fd_pr__nfet_01v8_lvt ad=0.435 pd=3.29 as=0.435 ps=3.29 w=3 l=1
X27 VOUT.t14 a_2479_7336.t23 VDD.t69 VDD.t5 sky130_fd_pr__pfet_01v8 ad=0.145 pd=1.29 as=0.145 ps=1.29 w=1 l=0.4
X28 VSS.t122 VSS.t121 VSS.t122 VSS.t8 sky130_fd_pr__nfet_01v8_lvt ad=1.015 pd=7.29 as=0 ps=0 w=7 l=1
X29 VDD.t51 VDD.t49 VDD.t51 VDD.t50 sky130_fd_pr__pfet_01v8 ad=0.145 pd=1.29 as=0 ps=0 w=1 l=0.4
X30 a_2995_7336.t13 VP.t1 a_2479_7336.t3 VSS.t9 sky130_fd_pr__nfet_01v8_lvt ad=1.015 pd=7.29 as=1.015 ps=7.29 w=7 l=1
X31 VSS.t120 VSS.t119 VSS.t120 VSS.t60 sky130_fd_pr__nfet_01v8_lvt ad=1.015 pd=7.29 as=0 ps=0 w=7 l=1
X32 a_3758_2896.t11 a_2080_2896.t14 VSS.t42 VSS.t38 sky130_fd_pr__nfet_01v8_lvt ad=0.435 pd=3.29 as=0.435 ps=3.29 w=3 l=1
X33 a_4920_2896.t17 a_2080_2896.t15 VSS.t35 VSS.t34 sky130_fd_pr__nfet_01v8_lvt ad=0.435 pd=3.29 as=0.435 ps=3.29 w=3 l=1
X34 a_2479_7336.t2 VP.t2 a_2995_7336.t12 VSS.t8 sky130_fd_pr__nfet_01v8_lvt ad=1.015 pd=7.29 as=1.015 ps=7.29 w=7 l=1
X35 a_3758_2896.t10 a_2080_2896.t16 VSS.t32 VSS.t16 sky130_fd_pr__nfet_01v8_lvt ad=0.435 pd=3.29 as=0.435 ps=3.29 w=3 l=1
X36 VOUT.t16 a_2479_7336.t24 VDD.t68 VDD.t5 sky130_fd_pr__pfet_01v8 ad=0.145 pd=1.29 as=0.145 ps=1.29 w=1 l=0.4
X37 VSS.t138 a_2080_2896.t17 a_3758_2896.t9 VSS.t53 sky130_fd_pr__nfet_01v8_lvt ad=0.435 pd=3.29 as=0.435 ps=3.29 w=3 l=1
X38 a_4920_2896.t26 a_4920_2896.t25 a_4920_2896.t26 VSS.t57 sky130_fd_pr__nfet_01v8_lvt ad=1.015 pd=7.29 as=0 ps=0 w=7 l=1
X39 a_4920_2896.t16 a_2080_2896.t18 VSS.t21 VSS.t20 sky130_fd_pr__nfet_01v8_lvt ad=0.435 pd=3.29 as=0.435 ps=3.29 w=3 l=1
X40 a_3758_2896.t8 a_2080_2896.t19 VSS.t134 VSS.t55 sky130_fd_pr__nfet_01v8_lvt ad=0.435 pd=3.29 as=0.435 ps=3.29 w=3 l=1
X41 a_3758_2896.t7 a_2080_2896.t20 VSS.t136 VSS.t91 sky130_fd_pr__nfet_01v8_lvt ad=0.435 pd=3.29 as=0.435 ps=3.29 w=3 l=1
X42 a_4920_2896.t24 EN.t0 VOUT.t0 VSS.t18 sky130_fd_pr__nfet_01v8_lvt ad=1.015 pd=7.29 as=1.015 ps=7.29 w=7 l=1
X43 a_2995_7336.t11 VP.t3 a_2479_7336.t15 VSS.t60 sky130_fd_pr__nfet_01v8_lvt ad=1.015 pd=7.29 as=1.015 ps=7.29 w=7 l=1
X44 VDD.t8 a_2479_9004.t6 a_2479_9004.t7 VDD.t7 sky130_fd_pr__pfet_01v8 ad=0.145 pd=1.29 as=0.145 ps=1.29 w=1 l=0.4
X45 VOUT.t13 VOUT.t11 VOUT.t12 VSS.t7 sky130_fd_pr__nfet_01v8_lvt ad=2.03 pd=14.58 as=0 ps=0 w=7 l=1
X46 a_4920_2896.t15 a_2080_2896.t21 VSS.t137 VSS.t0 sky130_fd_pr__nfet_01v8_lvt ad=0.435 pd=3.29 as=0.435 ps=3.29 w=3 l=1
X47 VDD.t48 VDD.t47 VDD.t48 VDD.t20 sky130_fd_pr__pfet_01v8 ad=0.145 pd=1.29 as=0 ps=0 w=1 l=0.4
X48 VSS.t44 a_2080_2896.t22 a_4920_2896.t14 VSS.t5 sky130_fd_pr__nfet_01v8_lvt ad=0.435 pd=3.29 as=0.435 ps=3.29 w=3 l=1
X49 VDD.t46 VDD.t45 VDD.t46 VDD.t34 sky130_fd_pr__pfet_01v8 ad=0.145 pd=1.29 as=0 ps=0 w=1 l=0.4
X50 VSS.t118 VSS.t117 VSS.t118 VSS.t33 sky130_fd_pr__nfet_01v8_lvt ad=1.015 pd=7.29 as=0 ps=0 w=7 l=1
X51 VDD.t67 a_2479_7336.t25 VOUT.t27 VDD.t14 sky130_fd_pr__pfet_01v8 ad=0.145 pd=1.29 as=0.145 ps=1.29 w=1 l=0.4
X52 VSS.t116 VSS.t114 VSS.t115 VSS.t77 sky130_fd_pr__nfet_01v8_lvt ad=0.87 pd=6.58 as=0 ps=0 w=3 l=1
X53 VSS.t113 VSS.t112 VSS.t113 VSS.t60 sky130_fd_pr__nfet_01v8_lvt ad=1.015 pd=7.29 as=0 ps=0 w=7 l=1
X54 VOUT.t10 VOUT.t8 VOUT.t9 VDD.t10 sky130_fd_pr__pfet_01v8 ad=0.29 pd=2.58 as=0 ps=0 w=1 l=0.4
X55 VSS.t46 a_2080_2896.t23 a_4920_2896.t13 VSS.t26 sky130_fd_pr__nfet_01v8_lvt ad=0.435 pd=3.29 as=0.435 ps=3.29 w=3 l=1
X56 VOUT.t7 VOUT.t6 VOUT.t7 VDD.t14 sky130_fd_pr__pfet_01v8 ad=0.145 pd=1.29 as=0 ps=0 w=1 l=0.4
X57 a_2995_7336.t15 VN.t3 a_2479_9004.t17 VSS.t60 sky130_fd_pr__nfet_01v8_lvt ad=1.015 pd=7.29 as=1.015 ps=7.29 w=7 l=1
X58 VDD.t66 a_2479_7336.t26 VOUT.t23 VDD.t0 sky130_fd_pr__pfet_01v8 ad=0.145 pd=1.29 as=0.145 ps=1.29 w=1 l=0.4
X59 VSS.t111 VSS.t109 VSS.t110 VSS.t2 sky130_fd_pr__nfet_01v8_lvt ad=2.03 pd=14.58 as=0 ps=0 w=7 l=1
X60 VDD.t44 VDD.t42 VDD.t43 VDD.t10 sky130_fd_pr__pfet_01v8 ad=0.29 pd=2.58 as=0 ps=0 w=1 l=0.4
X61 a_2479_9004.t5 a_2479_9004.t4 VDD.t3 VDD.t2 sky130_fd_pr__pfet_01v8 ad=0.145 pd=1.29 as=0.145 ps=1.29 w=1 l=0.4
X62 C1.t1 VOUT.t1 sky130_fd_pr__cap_mim_m3_1 l=25.5 w=25.5
X63 VDD.t65 a_2479_7336.t27 VOUT.t22 VDD.t0 sky130_fd_pr__pfet_01v8 ad=0.145 pd=1.29 as=0.145 ps=1.29 w=1 l=0.4
X64 VSS.t133 a_2080_2896.t24 a_3758_2896.t6 VSS.t20 sky130_fd_pr__nfet_01v8_lvt ad=0.435 pd=3.29 as=0.435 ps=3.29 w=3 l=1
X65 a_4920_2896.t12 a_2080_2896.t25 VSS.t15 VSS.t14 sky130_fd_pr__nfet_01v8_lvt ad=0.435 pd=3.29 as=0.435 ps=3.29 w=3 l=1
X66 VSS.t108 VSS.t107 VSS.t108 VSS.t33 sky130_fd_pr__nfet_01v8_lvt ad=1.015 pd=7.29 as=0 ps=0 w=7 l=1
X67 VOUT.t30 a_2479_7336.t28 VDD.t64 VDD.t17 sky130_fd_pr__pfet_01v8 ad=0.145 pd=1.29 as=0.145 ps=1.29 w=1 l=0.4
X68 VDD.t76 a_2479_9004.t21 a_2479_7336.t17 VDD.t7 sky130_fd_pr__pfet_01v8 ad=0.145 pd=1.29 as=0.145 ps=1.29 w=1 l=0.4
X69 VDD.t41 VDD.t40 VDD.t41 VDD.t31 sky130_fd_pr__pfet_01v8 ad=0.145 pd=1.29 as=0 ps=0 w=1 l=0.4
X70 VSS.t106 VSS.t105 VSS.t106 VSS.t22 sky130_fd_pr__nfet_01v8_lvt ad=1.015 pd=7.29 as=0 ps=0 w=7 l=1
X71 VDD.t39 VDD.t38 VDD.t39 VDD.t20 sky130_fd_pr__pfet_01v8 ad=0.145 pd=1.29 as=0 ps=0 w=1 l=0.4
X72 VOUT.t29 a_2479_7336.t29 VDD.t63 VDD.t17 sky130_fd_pr__pfet_01v8 ad=0.145 pd=1.29 as=0.145 ps=1.29 w=1 l=0.4
X73 VSS.t1 a_2080_2896.t26 a_3758_2896.t5 VSS.t0 sky130_fd_pr__nfet_01v8_lvt ad=0.435 pd=3.29 as=0.435 ps=3.29 w=3 l=1
X74 VSS.t104 VSS.t103 VSS.t104 VSS.t9 sky130_fd_pr__nfet_01v8_lvt ad=1.015 pd=7.29 as=0 ps=0 w=7 l=1
X75 VDD.t37 VDD.t36 VDD.t37 VDD.t28 sky130_fd_pr__pfet_01v8 ad=0.145 pd=1.29 as=0 ps=0 w=1 l=0.4
X76 VSS.t102 VSS.t101 VSS.t102 VSS.t11 sky130_fd_pr__nfet_01v8_lvt ad=1.015 pd=7.29 as=0 ps=0 w=7 l=1
X77 VDD.t35 VDD.t33 VDD.t35 VDD.t34 sky130_fd_pr__pfet_01v8 ad=0.145 pd=1.29 as=0 ps=0 w=1 l=0.4
X78 a_3758_2896.t4 a_2080_2896.t27 VSS.t6 VSS.t5 sky130_fd_pr__nfet_01v8_lvt ad=0.435 pd=3.29 as=0.435 ps=3.29 w=3 l=1
X79 VSS.t100 VSS.t99 VSS.t100 VSS.t10 sky130_fd_pr__nfet_01v8_lvt ad=1.015 pd=7.29 as=0 ps=0 w=7 l=1
X80 VSS.t98 VSS.t97 VSS.t98 VSS.t10 sky130_fd_pr__nfet_01v8_lvt ad=1.015 pd=7.29 as=0 ps=0 w=7 l=1
X81 VSS.t96 VSS.t95 VSS.t96 VSS.t88 sky130_fd_pr__nfet_01v8_lvt ad=0.435 pd=3.29 as=0 ps=0 w=3 l=1
X82 a_2995_7336.t10 VP.t4 a_2479_7336.t16 VSS.t33 sky130_fd_pr__nfet_01v8_lvt ad=1.015 pd=7.29 as=1.015 ps=7.29 w=7 l=1
X83 VSS.t94 VSS.t93 VSS.t94 VSS.t36 sky130_fd_pr__nfet_01v8_lvt ad=0.435 pd=3.29 as=0 ps=0 w=3 l=1
X84 a_4920_2896.t11 a_2080_2896.t28 VSS.t28 VSS.t3 sky130_fd_pr__nfet_01v8_lvt ad=0.435 pd=3.29 as=0.435 ps=3.29 w=3 l=1
X85 a_2479_7336.t6 VP.t5 a_2995_7336.t9 VSS.t22 sky130_fd_pr__nfet_01v8_lvt ad=1.015 pd=7.29 as=1.015 ps=7.29 w=7 l=1
X86 a_2080_2896.t2 a_2080_2896.t0 a_2080_2896.t1 VSS.t59 sky130_fd_pr__nfet_01v8_lvt ad=2.03 pd=14.58 as=0 ps=0 w=7 l=1
X87 a_2479_7336.t1 a_2479_9004.t22 VDD.t4 VDD.t2 sky130_fd_pr__pfet_01v8 ad=0.145 pd=1.29 as=0.145 ps=1.29 w=1 l=0.4
X88 VSS.t51 a_2080_2896.t29 a_4920_2896.t10 VSS.t24 sky130_fd_pr__nfet_01v8_lvt ad=0.435 pd=3.29 as=0.435 ps=3.29 w=3 l=1
X89 a_2995_7336.t0 VN.t4 a_2479_9004.t16 VSS.t11 sky130_fd_pr__nfet_01v8_lvt ad=1.015 pd=7.29 as=1.015 ps=7.29 w=7 l=1
X90 VOUT.t28 a_2479_7336.t30 VDD.t62 VDD.t50 sky130_fd_pr__pfet_01v8 ad=0.145 pd=1.29 as=0.145 ps=1.29 w=1 l=0.4
X91 a_4920_2896.t9 a_2080_2896.t30 VSS.t50 VSS.t34 sky130_fd_pr__nfet_01v8_lvt ad=0.435 pd=3.29 as=0.435 ps=3.29 w=3 l=1
X92 a_2479_9004.t15 VN.t5 a_2995_7336.t4 VSS.t10 sky130_fd_pr__nfet_01v8_lvt ad=1.015 pd=7.29 as=1.015 ps=7.29 w=7 l=1
X93 VDD.t56 a_2479_9004.t23 a_2479_7336.t9 VDD.t5 sky130_fd_pr__pfet_01v8 ad=0.145 pd=1.29 as=0.145 ps=1.29 w=1 l=0.4
X94 VDD.t32 VDD.t30 VDD.t32 VDD.t31 sky130_fd_pr__pfet_01v8 ad=0.145 pd=1.29 as=0 ps=0 w=1 l=0.4
X95 VSS.t62 a_2080_2896.t31 a_4920_2896.t8 VSS.t38 sky130_fd_pr__nfet_01v8_lvt ad=0.435 pd=3.29 as=0.435 ps=3.29 w=3 l=1
X96 VOUT.t17 a_2479_7336.t31 VDD.t61 VDD.t50 sky130_fd_pr__pfet_01v8 ad=0.145 pd=1.29 as=0.145 ps=1.29 w=1 l=0.4
X97 VSS.t63 a_2080_2896.t32 a_4920_2896.t7 VSS.t16 sky130_fd_pr__nfet_01v8_lvt ad=0.435 pd=3.29 as=0.435 ps=3.29 w=3 l=1
X98 a_2995_7336.t5 VN.t6 a_2479_9004.t14 VSS.t33 sky130_fd_pr__nfet_01v8_lvt ad=1.015 pd=7.29 as=1.015 ps=7.29 w=7 l=1
X99 VDD.t29 VDD.t27 VDD.t29 VDD.t28 sky130_fd_pr__pfet_01v8 ad=0.145 pd=1.29 as=0 ps=0 w=1 l=0.4
X100 a_4920_2896.t6 a_2080_2896.t33 VSS.t54 VSS.t53 sky130_fd_pr__nfet_01v8_lvt ad=0.435 pd=3.29 as=0.435 ps=3.29 w=3 l=1
X101 a_2479_9004.t13 VN.t7 a_2995_7336.t3 VSS.t22 sky130_fd_pr__nfet_01v8_lvt ad=1.015 pd=7.29 as=1.015 ps=7.29 w=7 l=1
X102 VSS.t61 a_2080_2896.t34 a_4920_2896.t5 VSS.t55 sky130_fd_pr__nfet_01v8_lvt ad=0.435 pd=3.29 as=0.435 ps=3.29 w=3 l=1
X103 VSS.t92 VSS.t90 VSS.t92 VSS.t91 sky130_fd_pr__nfet_01v8_lvt ad=0.435 pd=3.29 as=0 ps=0 w=3 l=1
X104 a_2995_7336.t8 VP.t6 a_2479_7336.t5 VSS.t11 sky130_fd_pr__nfet_01v8_lvt ad=1.015 pd=7.29 as=1.015 ps=7.29 w=7 l=1
X105 a_2479_7336.t4 VP.t7 a_2995_7336.t7 VSS.t10 sky130_fd_pr__nfet_01v8_lvt ad=1.015 pd=7.29 as=1.015 ps=7.29 w=7 l=1
X106 VSS.t89 VSS.t87 VSS.t89 VSS.t88 sky130_fd_pr__nfet_01v8_lvt ad=0.435 pd=3.29 as=0 ps=0 w=3 l=1
X107 VSS.t37 a_2080_2896.t35 a_3758_2896.t3 VSS.t36 sky130_fd_pr__nfet_01v8_lvt ad=0.435 pd=3.29 as=0.435 ps=3.29 w=3 l=1
X108 VSS.t4 a_2080_2896.t36 a_3758_2896.t2 VSS.t3 sky130_fd_pr__nfet_01v8_lvt ad=0.435 pd=3.29 as=0.435 ps=3.29 w=3 l=1
X109 VSS.t86 VSS.t84 VSS.t85 VSS.t77 sky130_fd_pr__nfet_01v8_lvt ad=0.87 pd=6.58 as=0 ps=0 w=3 l=1
X110 a_3758_2896.t1 a_2080_2896.t37 VSS.t25 VSS.t24 sky130_fd_pr__nfet_01v8_lvt ad=0.435 pd=3.29 as=0.435 ps=3.29 w=3 l=1
X111 VDD.t6 a_2479_9004.t2 a_2479_9004.t3 VDD.t5 sky130_fd_pr__pfet_01v8 ad=0.145 pd=1.29 as=0.145 ps=1.29 w=1 l=0.4
X112 VSS.t45 a_2080_2896.t38 a_3758_2896.t0 VSS.t34 sky130_fd_pr__nfet_01v8_lvt ad=0.435 pd=3.29 as=0.435 ps=3.29 w=3 l=1
X113 IBIAS.t1 IBIAS.t0 IBIAS.t1 VSS.t13 sky130_fd_pr__nfet_01v8_lvt ad=1.015 pd=7.29 as=0 ps=0 w=7 l=1
X114 VSS.t83 VSS.t82 VSS.t83 VSS.t43 sky130_fd_pr__nfet_01v8_lvt ad=1.015 pd=7.29 as=0 ps=0 w=7 l=1
X115 VDD.t26 VDD.t25 VDD.t26 VDD.t14 sky130_fd_pr__pfet_01v8 ad=0.145 pd=1.29 as=0 ps=0 w=1 l=0.4
X116 VSS.t27 a_2080_2896.t39 a_4920_2896.t4 VSS.t26 sky130_fd_pr__nfet_01v8_lvt ad=0.435 pd=3.29 as=0.435 ps=3.29 w=3 l=1
X117 VDD.t24 VDD.t22 VDD.t23 VDD.t10 sky130_fd_pr__pfet_01v8 ad=0.29 pd=2.58 as=0 ps=0 w=1 l=0.4
X118 IBIAS.t2 EN.t1 a_2080_2896.t7 VSS.t19 sky130_fd_pr__nfet_01v8_lvt ad=1.015 pd=7.29 as=1.015 ps=7.29 w=7 l=1
X119 VSS.t81 VSS.t80 VSS.t81 VSS.t11 sky130_fd_pr__nfet_01v8_lvt ad=1.015 pd=7.29 as=0 ps=0 w=7 l=1
X120 a_2479_7336.t0 a_2479_9004.t24 VDD.t1 VDD.t0 sky130_fd_pr__pfet_01v8 ad=0.145 pd=1.29 as=0.145 ps=1.29 w=1 l=0.4
X121 a_4920_2896.t3 a_2080_2896.t40 VSS.t48 VSS.t14 sky130_fd_pr__nfet_01v8_lvt ad=0.435 pd=3.29 as=0.435 ps=3.29 w=3 l=1
X122 a_4920_2896.t2 a_2080_2896.t41 VSS.t40 VSS.t20 sky130_fd_pr__nfet_01v8_lvt ad=0.435 pd=3.29 as=0.435 ps=3.29 w=3 l=1
X123 VOUT.t31 a_2479_7336.t32 VDD.t60 VDD.t7 sky130_fd_pr__pfet_01v8 ad=0.145 pd=1.29 as=0.145 ps=1.29 w=1 l=0.4
X124 a_2479_7336.t8 C1.t0 VSS.t49 sky130_fd_pr__res_xhigh_po_1p41 l=14
X125 VDD.t21 VDD.t19 VDD.t21 VDD.t20 sky130_fd_pr__pfet_01v8 ad=0.145 pd=1.29 as=0 ps=0 w=1 l=0.4
X126 VDD.t18 VDD.t16 VDD.t18 VDD.t17 sky130_fd_pr__pfet_01v8 ad=0.145 pd=1.29 as=0 ps=0 w=1 l=0.4
X127 a_3758_2896.t14 a_3758_2896.t13 a_3758_2896.t14 VSS.t23 sky130_fd_pr__nfet_01v8_lvt ad=1.015 pd=7.29 as=0 ps=0 w=7 l=1
X128 VOUT.t19 a_2479_7336.t33 VDD.t59 VDD.t7 sky130_fd_pr__pfet_01v8 ad=0.145 pd=1.29 as=0.145 ps=1.29 w=1 l=0.4
X129 VOUT.t5 VOUT.t4 VOUT.t5 VDD.t34 sky130_fd_pr__pfet_01v8 ad=0.145 pd=1.29 as=0 ps=0 w=1 l=0.4
X130 a_4920_2896.t1 a_2080_2896.t42 VSS.t135 VSS.t0 sky130_fd_pr__nfet_01v8_lvt ad=0.435 pd=3.29 as=0.435 ps=3.29 w=3 l=1
X131 a_3758_2896.t12 EN.t2 a_2995_7336.t1 VSS.t12 sky130_fd_pr__nfet_01v8_lvt ad=1.015 pd=7.29 as=1.015 ps=7.29 w=7 l=1
X132 VSS.t41 a_2080_2896.t43 a_4920_2896.t0 VSS.t5 sky130_fd_pr__nfet_01v8_lvt ad=0.435 pd=3.29 as=0.435 ps=3.29 w=3 l=1
X133 VOUT.t3 VOUT.t2 VOUT.t3 VDD.t20 sky130_fd_pr__pfet_01v8 ad=0.145 pd=1.29 as=0 ps=0 w=1 l=0.4
X134 VOUT.t20 a_2479_7336.t34 VDD.t58 VDD.t34 sky130_fd_pr__pfet_01v8 ad=0.145 pd=1.29 as=0.145 ps=1.29 w=1 l=0.4
X135 VSS.t79 VSS.t76 VSS.t78 VSS.t77 sky130_fd_pr__nfet_01v8_lvt ad=0.87 pd=6.58 as=0 ps=0 w=3 l=1
X136 a_2995_7336.t19 a_2995_7336.t17 a_2995_7336.t18 VSS.t52 sky130_fd_pr__nfet_01v8_lvt ad=2.03 pd=14.58 as=0 ps=0 w=7 l=1
X137 VDD.t15 VDD.t13 VDD.t15 VDD.t14 sky130_fd_pr__pfet_01v8 ad=0.145 pd=1.29 as=0 ps=0 w=1 l=0.4
X138 VSS.t75 VSS.t74 VSS.t75 VSS.t30 sky130_fd_pr__nfet_01v8_lvt ad=1.015 pd=7.29 as=0 ps=0 w=7 l=1
X139 VDD.t12 VDD.t9 VDD.t11 VDD.t10 sky130_fd_pr__pfet_01v8 ad=0.29 pd=2.58 as=0 ps=0 w=1 l=0.4
X140 a_2080_2896.t4 a_2080_2896.t3 VSS.t31 VSS.t26 sky130_fd_pr__nfet_01v8_lvt ad=0.435 pd=3.29 as=0.435 ps=3.29 w=3 l=1
X141 VSS.t73 VSS.t71 VSS.t72 VSS.t2 sky130_fd_pr__nfet_01v8_lvt ad=2.03 pd=14.58 as=0 ps=0 w=7 l=1
X142 VSS.t70 VSS.t69 VSS.t70 VSS.t43 sky130_fd_pr__nfet_01v8_lvt ad=1.015 pd=7.29 as=0 ps=0 w=7 l=1
X143 VDD.t57 a_2479_7336.t35 VOUT.t21 VDD.t2 sky130_fd_pr__pfet_01v8 ad=0.145 pd=1.29 as=0.145 ps=1.29 w=1 l=0.4
X144 VSS.t68 VSS.t67 VSS.t68 VSS.t30 sky130_fd_pr__nfet_01v8_lvt ad=1.015 pd=7.29 as=0 ps=0 w=7 l=1
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
R464 VSS.n2579 VSS.n20 585
R465 VSS.n2581 VSS.n2580 585
R466 VSS.n2583 VSS.n2582 585
R467 VSS.n2585 VSS.n2584 585
R468 VSS.n2587 VSS.n2586 585
R469 VSS.n2589 VSS.n2588 585
R470 VSS.n2591 VSS.n2590 585
R471 VSS.n2593 VSS.n2592 585
R472 VSS.n2595 VSS.n2594 585
R473 VSS.n2596 VSS.n41 585
R474 VSS.n41 VSS.n21 585
R475 VSS.n2598 VSS.n2597 585
R476 VSS.n2599 VSS.n2598 585
R477 VSS.n2578 VSS.n40 585
R478 VSS.n45 VSS.n40 585
R479 VSS.n2577 VSS.n2576 585
R480 VSS.n2576 VSS.n2575 585
R481 VSS.n43 VSS.n42 585
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
