lochidev/ttsky25_two_stage_opamp/cace/ttsky25_two_stage_opamp.yaml

#--------------------------------------------------------------
# CACE circuit characterization file
#--------------------------------------------------------------

name:           ttsky25_two_stage_opamp
description:    A Low-power Single-ended Operational Amplifier using Sky130 PDK
PDK:            sky130A

cace_format:    5.2

authorship:
  designer:         R. M. Lochana Mihisara Katugaha
  creation_date:    Sep 28, 2025
  license:          Apache 2.0

paths:
  root:             ..
  schematic:        xschem
  layout:           gds
  netlist:          netlist
  documentation:    docs

pins:
  VDD:
    description: Positive analog power supply
    type: power
    direction: inout
    Vmin: 1.7
    Vmax: 1.9
  VSS:
    description: Analog ground
    type: ground
    direction: inout
  IBIAS:
    description: Bias current input
    type: signal
    direction: inout
  VP:
    description: Voltage positive input
    type: signal
    direction: inout
  VN:
    description: Voltage negative input
    type: signal
    direction: inout
  VOUT:
    description: Voltage output
    type: signal
    direction: inout
  EN:
    description: Digital ENABLE input
    type: signal
    direction: inout

default_conditions:
  vdd:
    description: Analog power supply voltage
    display: Vdd
    unit: V
    typical: 1.8
  vcm_diff:
    description: Input common mode voltage is (vdd/2 - vcm_diff V) – (vdd/2 + vcm_diff V)
    display: vcm_diff
    unit: V
    typical: 0
  ibias:
    description: Bias current
    display: Ibias
    unit: uA
    typical: 5
  cl:
    description: Output load capacitance
    display: CLoad
    unit: pF
    typical: 25
  corner:
    description: Process corner
    display: Corner
    typical: tt
  temperature:
    description: Ambient temperature
    display: Temp
    unit: °C
    typical: 27
  lib_file:
    description: lib.spice file
    display: Lib_file
    typical: ngspice
parameters:
  netgen_lvs:
    description: Netgen LVS
    display: Netgen LVS
    spec:
      lvs_errors:
        maximum:
          value: 0
    tool:
      netgen_lvs:
        script: run_project_lvs.tcl
  dc_params:
    display: DC Params libs.tech/ngspice
    spec:
      gain_max:
        display: DC gain
        description: The DC gain in dB
        unit: dB
        minimum:
          value: any #actually 60 dB but any because of faliure
        typical:
          value: 60
        maximum:
          value: any
      ugf:
        display: Unity Gain Frequency
        description: The unity gain frequency
        unit: MHz
        minimum:
          value: 1
        typical:
          value: any
        maximum:
          value: any
      pm:
        display: Phase Margin
        description: The phase margin 
        unit: °
        minimum:
          value: 60
        typical:
          value: any
        maximum:
          value: any
    tool:
      ngspice:
        template: ac.sch
        format: ascii
        suffix: .data
        variables: [gain_max, ugf, pm]
    plot:
      gain_vs_temp_ngspice:
        type: xyplot
        xaxis: temperature
        yaxis: gain_max
        limits: auto
      ugf_vs_corner_ngspice:
        type: xyplot
        xaxis: corner
        yaxis: ugf
        limits: true
      pm_vs_vdd_ngspice:
        type: xyplot
        xaxis: vdd
        yaxis: pm
        limits: false
    conditions:
      corner:
        enumerate: [ss, tt, ff, fs, sf]
      vdd:
        minimum: 1.7
        typical: 1.8
        maximum: 1.9
      vcm_diff:
        minimum: -0.2
        typical: 0
        maximum: 0.2
      temperature:
        minimum: 20
        typical: 27
        maximum: 50
  dc_params_combined:
    display: DC Params libs.tech/combined
    spec:
      gain_max:
        display: DC gain combined
        description: The DC gain in dB
        unit: dB
        minimum:
          value: any #actually 60 dB but any because of faliure
        typical:
          value: 60
        maximum:
          value: any
      ugf:
        display: Unity Gain Frequency combined
        description: The unity gain frequency
        unit: MHz
        minimum:
          value: 1
        typical:
          value: any
        maximum:
          value: any
      pm:
        display: Phase Margin combined
        description: The phase margin 
        unit: °
        minimum:
          value: 60
        typical:
          value: any
        maximum:
          value: any
    tool:
      ngspice:
        template: ac.sch
        format: ascii
        suffix: .data
        variables: [gain_max, ugf, pm]
    plot:
      gain_vs_temp:
        type: xyplot
        xaxis: temperature
        yaxis: gain_max
        limits: auto
      ugf_vs_corner:
        type: xyplot
        xaxis: corner
        yaxis: ugf
        limits: true
      pm_vs_vdd:
        type: xyplot
        xaxis: vdd
        yaxis: pm
        limits: false
    conditions:
      corner:
        enumerate: [ss, tt, ff, fs, sf]
      vdd:
        minimum: 1.7
        typical: 1.8
        maximum: 1.9
      vcm_diff:
        minimum: -0.2
        typical: 0
        maximum: 0.2
      temperature:
        minimum: 20
        typical: 27
        maximum: 50
      lib_file:
        typical: combined

  gain_mc:
    display: DC Params MC
    spec:
      gain_max:
        display: DC gain MC
        description: DC gain Monte Carlo
        unit: dB
        minimum:
          value: any #actually 60 dB but any because of faliure
        typical:
          value: any
        maximum:
          value: any
      ugf:
        display: Unity Gain Frequency MC
        description: The unity gain frequency Monte Carlo
        unit: MHz
        minimum:
          value: any #actually 1 Mhz but any because of faliure
        typical:
          value: any
        maximum:
          value: any
      pm:
        display: Phase Margin MC
        description: The phase margin Monte Carlo
        unit: °
        minimum:
          value: any #actually 60° but any because of faliure
        typical:
          value: any
        maximum:
          value: any
    tool:
      ngspice:
        template: ac.sch
        # Merge runs with the same conditions
        # but different iterations
        # This is used for plotting
        collate: iterations
        format: ascii
        suffix: .data
        variables: [gain_max, ugf, pm]
        script: save_mc_csv.py
        script_variables: [gain_max, ugf, pm]
    plot:
      gain_mc:
        type: histogram
        xaxis: gain_max
        limits: auto
      ugf_mc:
        type: histogram
        xaxis: ugf
        limits: auto
      pm_mc:
        type: histogram
        xaxis: pm
        limits: auto
    conditions:
      iterations:
        description: Iterations to run
        display: Iterations
        minimum: 1
        maximum: 150
        step: linear
        stepsize: 1
      corner:
        typical: mc
      lib_file:
        typical: combined
      temperature:
        minimum: 20
        typical: 27
        maximum: 50
      vdd:
        minimum: 1.7
        typical: 1.8
        maximum: 1.9
      vcm_diff:
        minimum: -0.2
        typical: 0
        maximum: 0.2
  transient_response:
    description: Large signal transient response
    display: Large signal transient response
    status: skip
    unit: mV
    tool:
      ngspice:
        template: transient.sch
        format: ascii
        suffix: .data
        variables: [time, Vout, Vinp]
        jobs: 4
    plot:
      transient:
        suffix: .svg
        xaxis: time
        yaxis: [Vout, Vinp]
    variables:
      time:
        display: Time
        unit: ms
      Vinp:
        display: Vinp
        unit: V
      Vout:
        display: Vout
        unit: V
    conditions:
      Tmax:
        display: Simulation time
        unit: ns
        typical: 500
      temperature:
        minimum: 20
        typical: 27
        maximum: 50
      corner:
        minimum: ss
        typical: tt
        maximum: ff
  
  magic_area:
    spec:
      area:
        display: Area
        description: Total circuit layout area
        unit: µm²
        maximum:
          value: 11200
      width:
        display: Width
        description: Total circuit layout width
        unit: µm
        maximum:
          value: any
      height:
        display: Height
        description: Total circuit layout height
        unit: µm
        maximum:
          value: any
    tool:
      magic_area

  magic_drc:
    description: Magic DRC
    display: Magic DRC
    spec:
      drc_errors:
        maximum:
          value: 0
    tool:
      magic_drc:
        gds_flatten: true

  klayout_drc_feol:
    description: KLayout DRC feol
    display: KLayout DRC feol
    spec:
      drc_errors:
        maximum:
          value: 0
    tool:
        klayout_drc:
            jobs: max
            args: ['-rd', 'feol=true']

  klayout_drc_beol:
    description: KLayout DRC beol
    display: KLayout DRC beol
    spec:
      drc_errors:
        maximum:
          value: 0
    tool:
        klayout_drc:
            jobs: max
            args: ['-rd', 'beol=true']

  klayout_drc_full:
    description: KLayout DRC full
    display: KLayout DRC full
    spec:
      drc_errors:
        maximum:
          value: 0
    tool:
        klayout_drc:
            jobs: max
            args: ['-rd', 'feol=true', '-rd', 'beol=true', '-rd', 'offgrid=true']

  klayout_lvs:
    description: KLayout LVS
    display: KLayout LVS
    spec:
      lvs_errors:
        maximum:
          value: 0
    tool:
        klayout_lvs:
            jobs: max
            args: [
              '-rd', 'spice_net_names=true',
              '-rd', 'spice_comments=true',
              '-rd', 'scale=true',
              '-rd', 'verbose=true',
              '-rd', 'schematic_simplify=true',
              '-rd', 'net_only=true',
              '-rd', 'top_lvl_pins=true',
              '-rd', 'combine=true',
              '-rd', 'purge=true',
              '-rd', 'purge_nets=true',
              '-rd', 'lvs_sub=VSS',
              '-rd', 'convert_subckts=true',
            ]

  magic_antenna_check:
    description: Run antenna violation check using magic
    display: Antenna Checks
    spec:
      antenna_violations:
        maximum:
          value: 0
    tool:
        magic_antenna_check
