lochidev/ttsky25_two_stage_opamp/(commit log)

2025-09-19 add updated layout with resistor drc issue fixed
2025-09-21 added pre-layout and post-layout xschem files
    [tb_Opamp.sch, tb_Opamp_OP.sch, tb_Opamp_input_offset.sch, tb_Opamp_slewrate.sch, tb_Opamp_slewrate_positive.sch, tb_Opamp_transient.sch, tb_closed_loop_slew_rate.sch, tb_closed_loop_slew_rate_positive.sch]
2025-09-25 update schematic with proper dummy transistors
    [two_stage_op_amp.sch, two_stage_op_amp_lvs.sch]
2025-09-26 update schematics + test tiny tapeout template files
2025-09-26 updated layout to reflect new schematic - lvs failing
2025-09-26 fixed enable switch bug
    [two_stage_op_amp_lvs.sch]
2025-09-27 fix enable switch
    [two_stage_op_amp.sch, two_stage_op_amp_lvs.sch]
2025-09-27 good design but worse than first post layout design. backup before revertin all changes
    [two_stage_op_amp.sch]
2025-09-27 restore documented design - restored to Commit e558a4b
    [two_stage_op_amp.sch, two_stage_op_amp_lvs.sch]
2025-09-27 backup compact layout files
    [tb_Opamp.sch]
2025-09-27 fixed symbol port order + added spice file for compact layout after PEX
    [tb_Opamp_OP.sch]
2025-09-28 exploring cace
    [ac.sch, tb_Opamp.sch, transient.sch, ttsky25_two_stage_opamp.sch, ttsky25_two_stage_opamp_tb.sch]
2025-09-28 add cace results
    [simulation_summary.csv]
2025-09-28 add results from cace to docs
    [simulation_summary.csv]
2025-09-28 testing updated results
    [simulation_summary.csv]
2025-09-28 updated testbenches
    [ac.sch, tb_Opamp.sch, tb_Opamp_OP.sch, tb_Opamp_input_offset.sch, tb_Opamp_slewrate.sch, tb_Opamp_slewrate_positive.sch, tb_Opamp_transient.sch, tb_closed_loop_slew_rate.sch]
2025-09-28 update CACE yaml file to use the ngspice sky130 lib.spice file - test
    [ac.sch, transient.sch]
2025-09-29 fix symbol in testbenches
    [tb_Opamp_OP.sch, tb_Opamp_input_offset.sch, tb_Opamp_slewrate.sch, tb_Opamp_slewrate_positive.sch, tb_Opamp_transient.sch, tb_closed_loop_slew_rate.sch, tb_closed_loop_slew_rate_positive.sch]
2025-09-29 fix errors in layout plan enable switches
2025-10-03 change testbenches
    [tb_Opamp.sch, tb_Opamp_OP.sch, tb_Opamp_transient_closed_loop.sch, tb_closed_loop_slew_rate.sch, tb_closed_loop_slew_rate_positive.sch, ttsky25_two_stage_opamp_tb.sch]
2025-10-04 update docs + fix testbenches + update symbol
    [ac.sch, tb_Opamp_OP.sch, tb_Opamp_VTC_input_offset.sch, tb_Opamp_input_offset.sch, tb_Opamp_slewrate.sch, tb_Opamp_slewrate_positive.sch, transient.sch]
2025-10-04 ensuring everything is correct before finalzing design
    [ttsky25_two_stage_opamp.yaml]
2025-10-05 add python script to extract monte carlo results
    [mc_results_full.csv, simulation_summary.csv]
2025-10-05 add python script to extract full monte-carlo data from CACE
    [mc_results_full.csv]
2025-10-05 upddate results for monte-carlo
    [mc_results_full.csv, simulation_summary.csv]
2025-10-06 try out monte carlo with common mode voltage variations
    [ac.sch, mc_3600_no_vcm.xlsx, mc_results_full.csv, mc_results_full_excel.xlsx, tb_Opamp_OP.sch, tb_Opamp_VTC_input_offset.sch, tb_Opamp_transient.sch, tb_Opamp_transient_closed_loop.sch]
2025-10-06 update results
    [mc_results_full.csv, simulation_summary.csv]
2025-10-06 fix mistakes
    [mc_results_full.csv]
2025-10-19 probably the final submission
    [tb_Opamp_transient_closed_loop.sch]
2025-10-20 add notes to schematic
    [ttsky25_two_stage_opamp.sch]
2025-11-17 backing up all files
    [tb_Opamp.sch, tb_Opamp_transient_closed_loop.sch, ttsky25_two_stage_opamp_tb.sch]
